deskpro256/Hansab_parking_counter/Parking Project/Installations/ConfiguratorTests/Schematic/Slave_pcb_IRL1.jpg

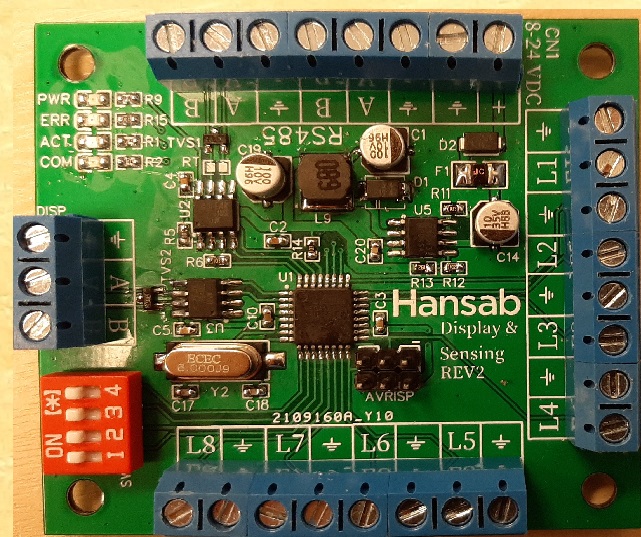
Parking Project/Installations/ConfiguratorTests/Schematic/Slave_pcb_IRL1.jpg
