deskpro256/Hansab_parking_counter/Parking Project/Installations/Installer/readme.txt

Open Setup.msi and install the software.
Upon launching the software either enter username & password
and let the dialog box add your licence
or press the change licence button to add your licence and then log in
