deskpro256/Hansab_parking_counter/Documentation/Hansab_device_specification.pdf

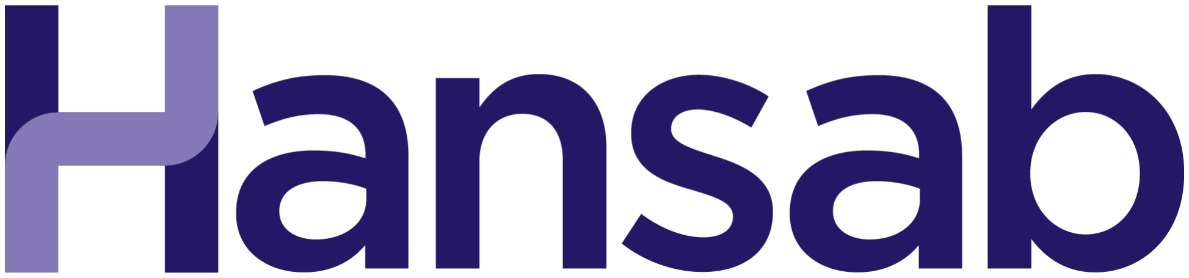
[picture p3: figure]

AUTOSTAVVIETAS BR ¯ | ¯IVO VIETU

# SKAIT¯ITAJS ¯

## Saturs

1. RISINAJUMA APRAKSTS | 2 ¯
2. UZSTAD¯ ¯ISANAS INSTRUKCIJA | 2 ˇ
3. PROGRAMMATURA ¯ | 2
4. ’INTERFEISA’ IER¯ICE | 11
5. ’SLAVE’ IER¯ICE | 18
6. RS485 DATU PROTOKOLS | 23
7. PIELIKUMS | | 25
8. IZMAIN¸ U ZURN ˇ | ALS ¯ | 25

## 1. RISINAJUMA APRAKSTS ¯

1.1. —==[]==—

Nulla malesuada porttitor diam. Donec felis erat, congue non, volutpat at, tincidunt tristique, libero. Vivamus viverra fermentum felis. Donec nonummy pellentesque ante. Phasellus adipiscing semper elit. Proin fermentum massa ac quam. Sed diam turpis, molestie vitae, placerat a, molestie nec, leo. Maecenas lacinia. Nam ipsum ligula, eleifend at, accumsan nec, suscipit a, ipsum. Morbi blandit ligula feugiat magna. Nunc eleifend consequat lorem. Sed lacinia nulla vitae enim. Pellentesque tincidunt purus vel magna. Integer non enim. Praesent euismod nunc eu purus. Donec bibendum quam in tellus. Nullam cursus pulvinar lectus. Donec et mi. Nam vulputate metus eu enim. Vestibulum pellentesque felis eu massa.

## 2. UZSTAD¯ ¯ISANAS INSTRUKCIJA ˇ

2.1. —==[]==—

Nam dui ligula, fringilla a, euismod sodales, sollicitudin vel, wisi. Morbi auctor lorem non justo. Nam lacus libero, pretium at, lobortis vitae, ultricies et, tellus. Donec aliquet, tortor sed accumsan bibendum, erat ligula aliquet magna, vitae ornare odio metus a mi. Morbi ac orci et nisl hendrerit mollis. Suspendisse ut massa. Cras nec ante. Pellentesque a nulla. Cum sociis natoque penatibus et magnis dis parturient montes, nascetur ridiculus mus. Aliquam tincidunt urna. Nulla ullamcorper vestibulum turpis. Pellentesque cursus luctus mauris.

Sist¯emas sl¯egumu piem¯era diagramma:

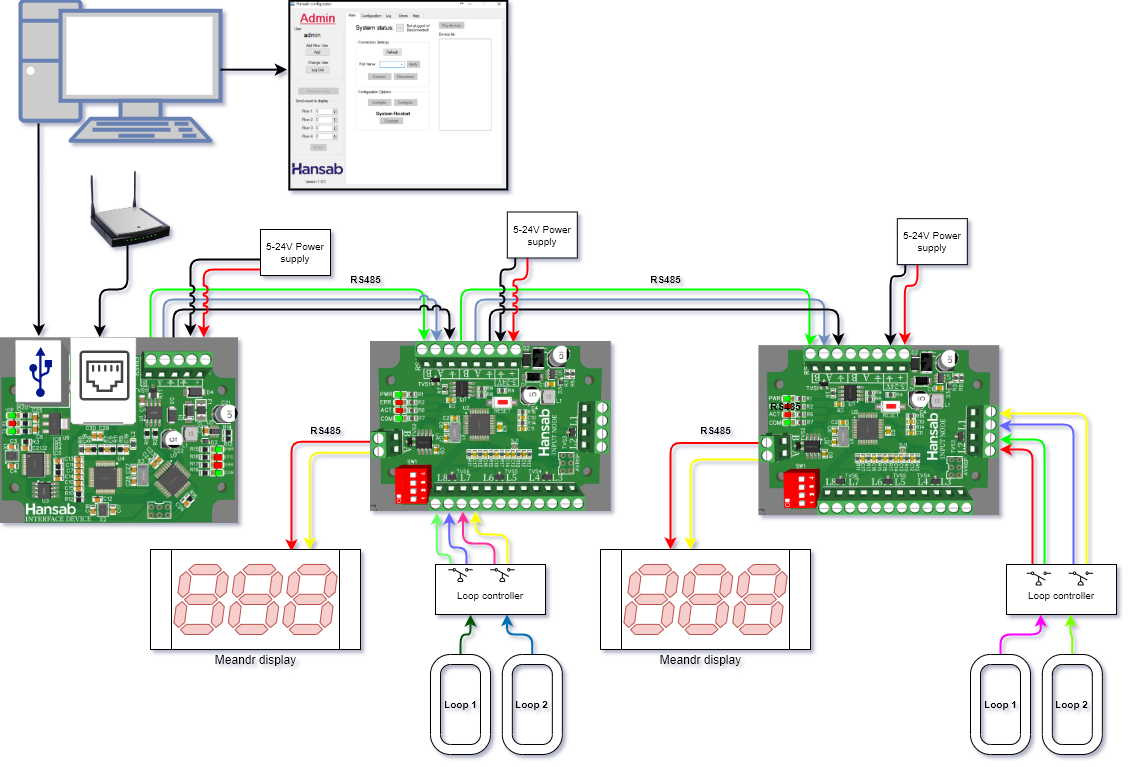
[picture p4: figure]

## 3. PROGRAMMATURA ¯

3.1. —==[]==—

### 3.2. Programmat¯uras apraksts

Programma nepieciešama, lai iestat¯ıtu s¯akotn¯ejo konfigur¯aciju, kur¯a nosaka cik ’slave’ ier¯ıces ir sist¯em¯a, to iestat¯ıjumi, k¯a ar¯ı citi sist¯emas iestat¯ıjumi.
’Interfeisa’ ier¯ıce j¯apiesl¯edz datoram izmantojot USB Type-B vadu, j¯aatver programma. Piekl¸uves log¯a j¯aievada sava lietot¯aja v¯ards un parole. P¯ec vajadz¯ıbas, var izveidot jaunu lietot¯aju, gan admin, gan guest lietot¯aju, kuram b¯us maz¯aka piekl¸uve konfigur¯acijai, bet sist¯emu var¯es p¯arstart¯et un izmain¯ıt pašreiz¯ejo skaitu, ja nepieciešams. Admin lietot¯ajam ir dota pilna kontrole p¯ar sist¯emu.
Lai iestat¯ıtu t¯ıkla iestat¯ıjumus, tas tiek dar¯ıts šaj¯a prgramm¯a.
—-=[+v¯el teksts?]=—-
Lorem ipsum dolor sit amet, consectetuer adipiscing elit. Ut purus elit, vestibulum ut, placerat ac, adipiscing vitae, felis. Curabitur dictum gravida mauris. Nam arcu libero, nonummy eget, consectetuer id, vulputate a, magna. Donec vehicula augue eu neque. Pellentesque habitant morbi tristique senectus et netus et malesuada fames ac turpis egestas. Mauris ut leo. Cras viverra metus rhoncus sem. Nulla et lectus vestibulum urna fringilla ultrices. Phasellus eu tellus sit amet tortor gravida placerat. Integer sapien est, iaculis in, pretium quis, viverra ac, nunc. Praesent eget sem vel leo ultrices bibendum. Aenean faucibus. Morbi dolor nulla, malesuada eu, pulvinar at, mollis ac, nulla. Curabitur auctor semper nulla. Donec varius orci eget risus. Duis nibh mi, congue eu, accumsan eleifend, sagittis quis, diam. Duis eget orci sit amet orci dignissim rutrum.

### 3.3. Programmat¯uras pam¯ac¯ıba

Piekl¸uves logs:

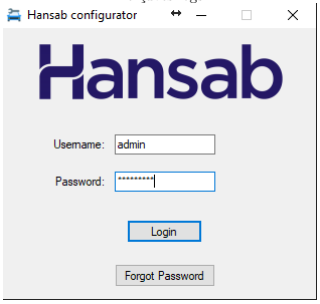
[picture p5: figure]

Piekl¸uves log¯a ievadiet savu lietot¯aja v¯ardu un paroli. Ja parole ir aizmirsusies, nospiediet ’Forgot password’ pogu.
Noklus¯et¯a lietot¯aja dati:
Username: admin
Password: Hansab123
Username: guest
Password: Guest123

Aizmirsu paroli logs:

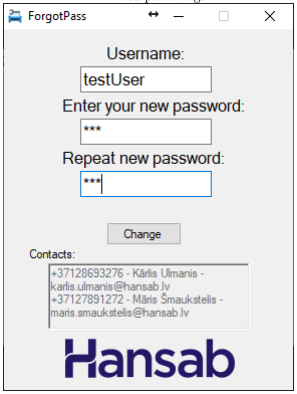
[picture p6: figure]

P¯ec pogas ’Forgot password’ nospiešanas atveras šis logs. Ievadiet savu lietot¯aja v¯ardu un jauno paroli, k¯a ar¯ı atk¯artojiet jauno paroli. Nospiediet pogu ’Change’ un parole tiks nomain¯ıta. P¯ec tam varat m¯e ‘gin¯at piekl¸¯ut atk¯artoti.

Lietot¯aja galvenais logs:

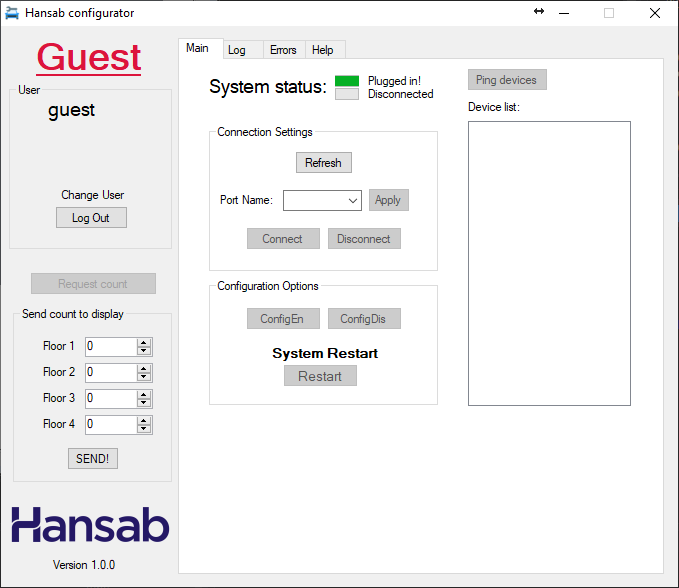
[picture p7: figure]

Ja lietot¯aja tips ir ’Guest’, tad šim lietot¯ajam ir liegta piekl¸uve uz sist¯emai svar¯ıgiem iestat¯ıjumiem. Piem¯eram, nevar izmain¯ıt sist¯emas konfigur¯aciju un nevar izveidot jaunu lietot¯aju.
P¯ec nepieciešam¯ıbas var izmain¯ıt pašreiz¯ejo skaitu k¯adai no ’slave’ ier¯ıc¯em, ja t¯am konstat¯eta kl¸¯uda skait¯a. Gan ’Guest’, gan ’Admin’ lietot¯ajiem, piesl¯edzot ’Interfeisa’ ier¯ıci pie datora, sist¯emas statusa gaismiņa nomain¯ısies no pel¯ekas uz zal¸u, k¯a ar¯ı teksts nomain¯ısies uz ’Online!/Connected!’

Admin galvenais logs:

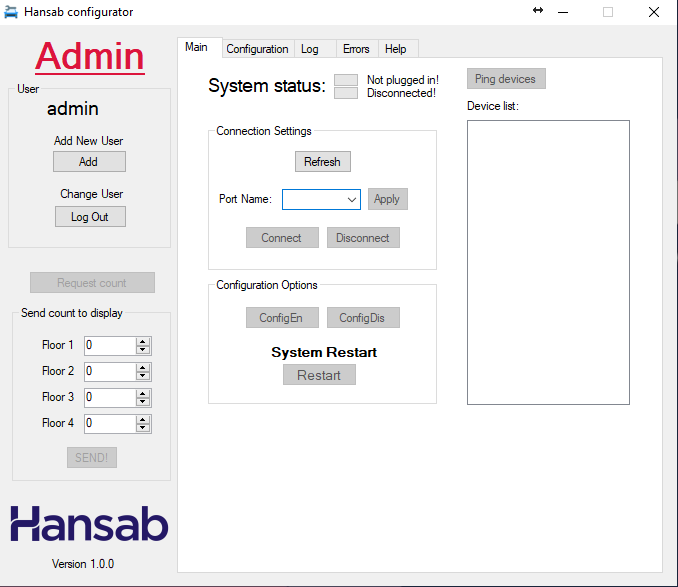
[picture p8: figure]

Ja lietot¯aja tips ir ’Admin’, tad šim lietot¯ajam ir piekl¸uve uz visiem sist¯emas iestat¯ıjumiem.
Var pievienot jaunus lietot¯ajus, gan ’Admin’, gan ’Guest’ tipa, izmain¯ıt vai uzst¯ad¯ıt jaunu sist¯emas konfigur¯aciju.
Gan ’Guest’, gan ’Admin’ lietot¯ajiem, piesl¯edzot ’Interfeisa’ ier¯ıci pie datora, sist¯emas statusa gaismiņa nomain¯ısies no pel¯ekas uz zal¸u, k¯a ar¯ı teksts nomain¯ısies uz ’Online!/Connected!’

Admin konfigur¯acijas logs:

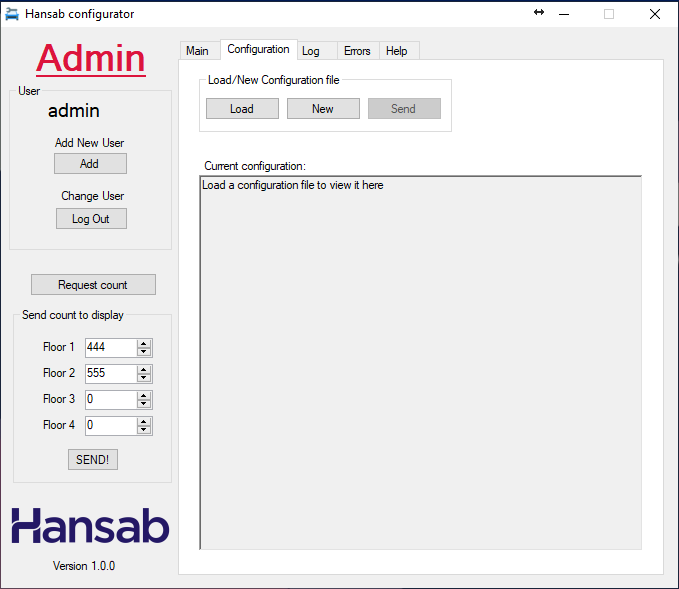
[picture p9: figure]

Uzspiežot uz ’Configuration’ cilnes, par¯ad¯as 2 pogas un teksta logs:

’Load’ - Iel¯ad¯e jau esošu konfigur¯acijas failu no saglab¯ata faila;
’New’ - Atver jaunu logu, kur¯a iesp¯ejams izveidot jaunu konfigur¯acijas failu;
’Current configuration’ teksta logs - kur¯a, p¯ec esošas konigur¯acijas faila iel¯ad¯ešanas, par¯ad¯as š¯ı faila saturs. P¯ec tam šo konfigur¯aciju var iel¯ad¯et uz pašreiz¯ej¯as sist¯emas.

Admin konfigur¯acijas logs:

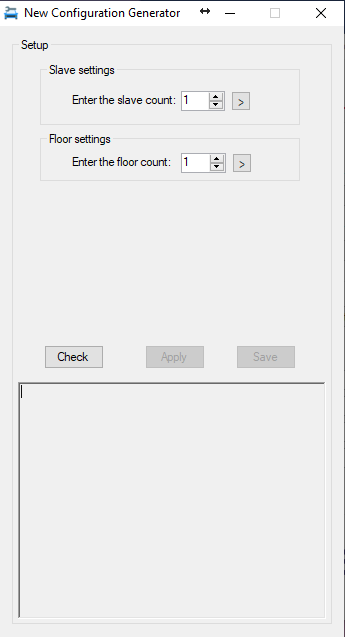
[picture p10: figure]

Ja tiek veikta jauna konfigur¯acijas uzst¯ade, atveras jauns logs, kur¯a iesp¯ejams iestat¯ıt šlave¯ıer¯ıču skaitu sist¯em¯a, k¯a ar¯ı st¯avu skaitu un to individu¯alo br¯ıvo vietu skaitu.

Admin konfigur¯acijas logs:

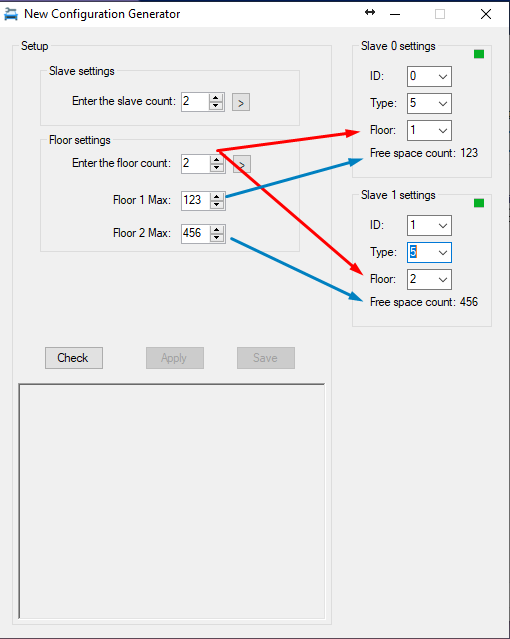
[picture p11: figure]

Sadal¸¯a ’Floor n’ (n - st¯ava skaits) par¯ad¯ısies ’Free space count’, kur¯a j¯aievada st¯avlaukuma br¯ıvo vietu skaits un ’Slave count’, kur¯a j¯aievada piesl¯egto ’slave’ ier¯ıču skaits. Nospiežam ’Next’
Par¯ad¯ısies jauna sadal¸a ’Slave settings’, kur¯a iesp¯ejams iestat¯ıt ’slave’ ier¯ıču datus:
Ier¯ıces ID (0-15)
Ier¯ıces tipu (1-3)
Ier¯ıces st¯avu/zonu (1-4)

Ier¯ıces tipu apraksts:

Tips 1: | [↓] [↑] - Atsevišk¸a iebrauktuve un atsevišk¸a izbrauktuve
Tips 2: | [Eko] - Ekonomiskais(ar vienu cilpu) Tikai iebrauktuve / izbrauktuve
Tips 3: | [↓ ↑] - Kop¯eja iebrauktuve/izbrauktuve

Admin konfigur¯acijas logs:

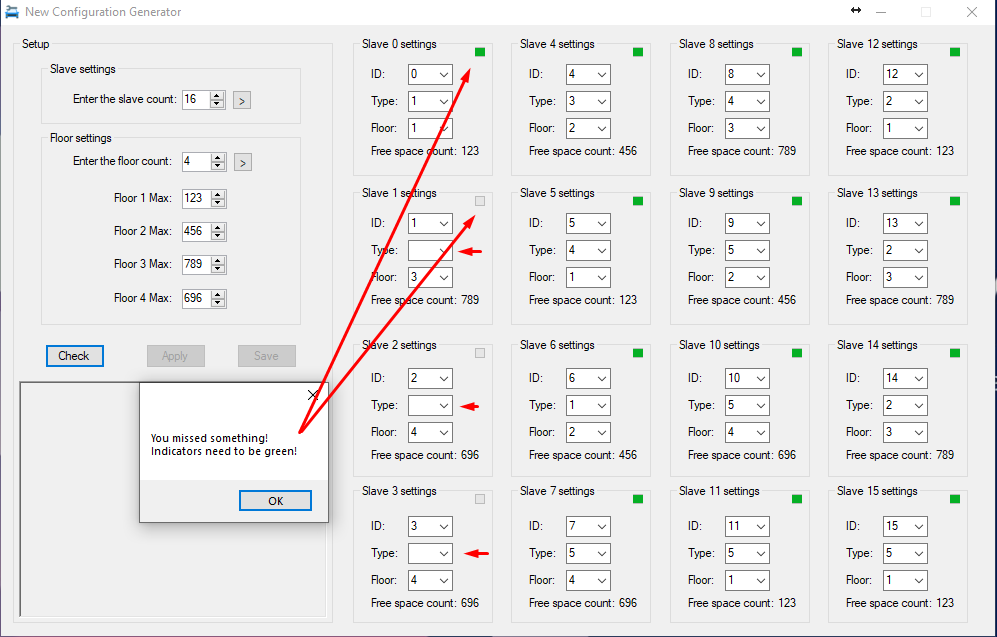
[picture p12: figure]

Kad visi iestat¯ıjumi uzst¯ad¯ıti, nospiediet ’Check’, kas p¯arbaud¯ıs vai visi nepieciešamie lauciņi ir aizpild¯ıti.
Ja nav aizpild¯ıti visi lauciņi, p¯ec ’Check’ pogas nospiešanas par¯ad¯ısies att¯el¯a redzamais logs, kas br¯ıdina, ka j¯us neesat aizpild¯ıjis visus lauciņus. Pel¯ekie indikatori p¯arv¯eršas par zal¸iem, ja ’slave settings’ lauciņš ir aizpild¯ıts. Tom¯er, ja viss aizpild¯ıts pareizi, atsl¯egsies pogas ’Apply’ un ’Save’, kas l¸aus j¯usu izveidoto konfigur¯aciju saglab¯at k¯a failu, k¯a ar¯ı p¯ec tam nos¯ut¯ıt uz uzst¯ad¯ıto sist¯emu.

Jauna lietot¯aja pievienošana:

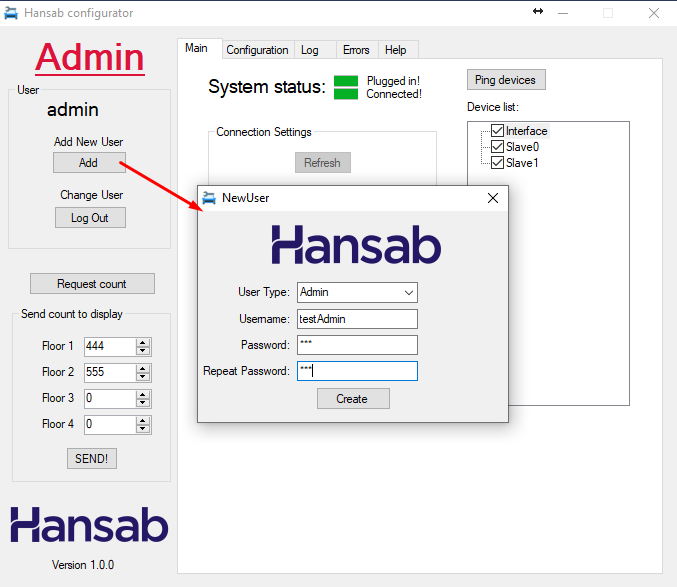
[picture p13: figure]

Ja vajadz¯ıgs izveidot jaunu lietot¯aju, to var izdar¯ıt nospiežot uz pogas ’Add’ galven¯a pragrammas loga kreisaj¯a mal¯a, kas atv¯ers šo logu.
Izv¯elieties lietot¯aja tipu (Guest/Admin).
Ievadiet lietot¯aja v¯ardu, paroli un v¯elreiz atk¯artojiet paroli.
Nospiežot ’Create’, tiks izveidots jaunais lietot¯ajs un par¯ad¯ısies logs, inform¯ejot par to.

Kl¸¯udu saraksta logs:

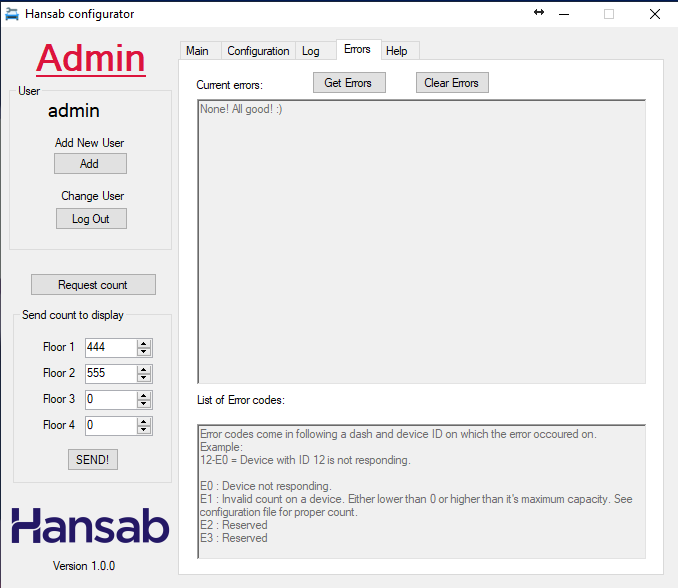
[picture p14: figure]

Saj¯a ciln¯e atrodama aktu¯al¯a inform¯acija par uzst¯ad¯ıt¯as sist¯emas kl¸¯udu sarakstu. ˇ
Ja k¯adu iemeslu d¯el¸ sist¯em¯a ir radusies kl¸¯uda, piesl¯edzot ’Interfeisa’ ier¯ıci pie datora, šeit tiks izveidots saraksts ar kl¸¯udainaj¯am ier¯ıc¯em ar to aprakstiem.

Piem¯ers:
Ja kl¸¯udu nav, tekstlog¯a ’Current errors’ b¯us rakst¯ıts: ’None! All good! :)
Zem¯akaj¯a tekstlog¯a ’List of error codes’ ir apraksts, k¯a las¯ıt kl¸¯udas sarakst¯a doto inform¯aciju.

Kl¸¯udu kodu piem¯ers:

12-E1
Saprast: Ier¯ıce ar ID 12 neatsaucas.

Kl¸¯udu kodu saraksts:

E0 : Nav kl¸¯udas;
E1 : Ier¯ıce neatsaucas;
E2 : Nepareizs br¯ıvo vietu skaits ier¯ıc¯e. Skat¯ıt konfigur¯acijas failu p¯ec atbilstoš¯a pareiz¯a skaita; E3 : Rezerv¯ets.

Pal¯ıdz¯ıbas logs:

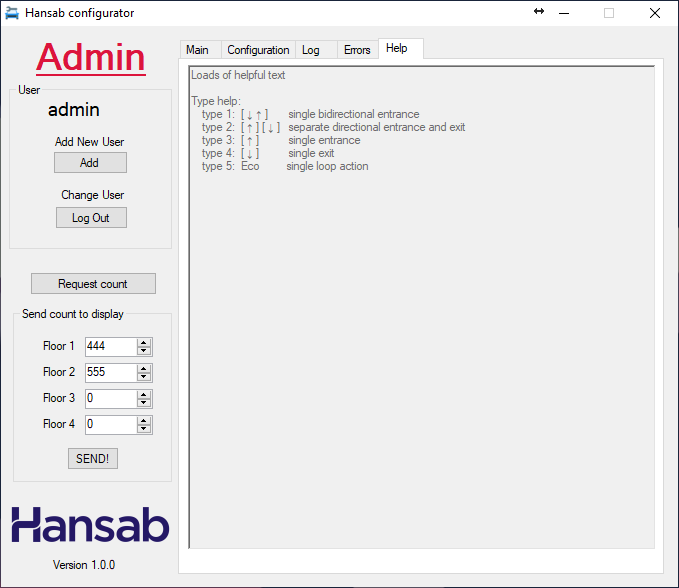
[picture p15: figure]

Saj¯a ciln¯e atrodama inform¯acija, kas noder¯etu uzst¯ades br¯ıd¯ı, k¯a ar¯ı p¯ec t¯as. ˇ Varb¯ut ar¯ı kontakti k¯adi?—??
Links uz Hansab lapu ar šo risin¯ajumu? https://www.hansab.lv/404

## 4. ’INTERFEISA’ IER¯ICE

4.1. ’Interfeisa’ ier¯ıces apraksts

’Interfeisa’ ier¯ıce nodrošina galveno saziņu starp sist¯em¯a sasl¯egtaj¯am ier¯ıc¯em, k¯a ar¯ı savienojumam ar datoru un konfigur¯acijas programmat¯uru.
’Interfeisa’ ier¯ıce ar datoru sazinas izmantojot USB, bet ar vis¯am p¯ar¯ej¯am ’slave’ ier¯ıc¯em sazinas izmantojot RS485 ar pašizveidotu datu protokolu, kas aprakst¯ıts t¯al¯ak dokument¯a, sadal¸¯a ’RS485 DATU PROTO-KOLS’.

Papildus ier¯ıc¯e darbojas WebServeris, kur¯a iesp¯ejams piesl¯egties att¯alin¯ati un var redz¯et sist¯emas statusu un izmain¯ıt sist¯emas pašreiz¯ejo skaitu.

Ier¯ıcei var piekl¸¯ut ar jebkuru t¯ıkla p¯arl¯uk apal¯ıdz¯ıbu, ierakstot saites lodziņ¯a iek¯artas IP adresi.

Interfeisa ier¯ıces WebServera ielogošan¯as logs:

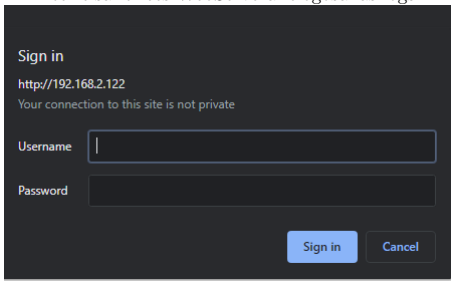
[picture p16: figure]

Seit ievadam savu lietot¯ajv¯ardu un paroli lai turpin¯atu uz galveno lapu. ˇ

Interfeisa ier¯ıces WebServera pašreiz¯ejo datu lapa:

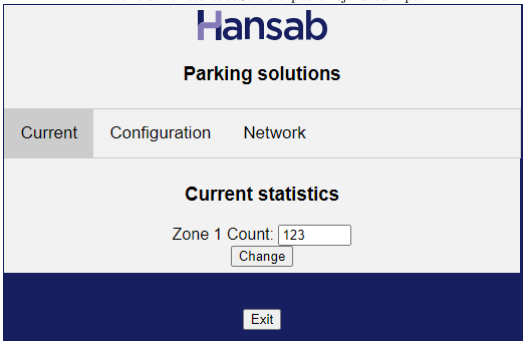
[picture p17: figure]

Seit varam redz¯et datus par pašreiz¯ejo skaitu sist¯em¯a un tos izmain¯ıt nos¯utot tos uz ier¯ıci. ˇ

Interfeisa ier¯ıces WebServera sist¯emas iestat¯ıjumi:

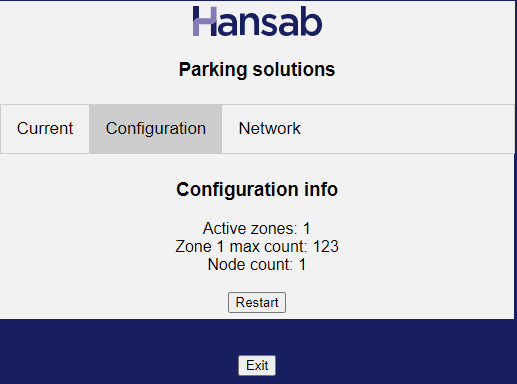
[picture p18: figure]

Seit apskat¯ami dati par to, k¯a sist¯ema uzst¯ad¯ıta. Aprakst¯ıti maksim¯alie skaitl¸i un tas, cik zonas/st¯avi sist¯em¯a ˇ tiek lietoti, k¯a ar¯ı ’slave’ iek¯artu skaits. P¯ec nepieciešam¯ıbas, var iek¯artu ar¯ı p¯arstart¯et.

Interfeisa ier¯ıces WebServera t¯ıkla iestat¯ıjumi:

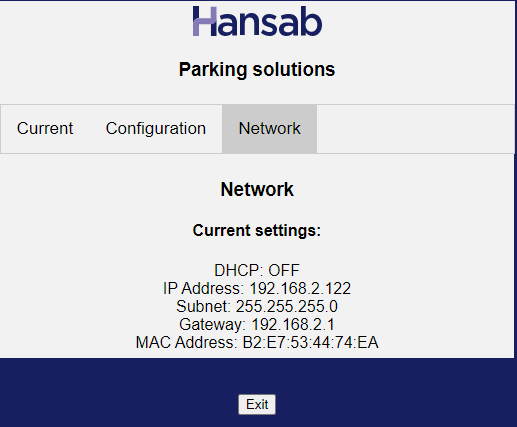
[picture p19: figure]

Seit var redz¯et ier¯ıces pašreiz¯ejos t¯ıkla iestat¯ıjumus. ˇ

Ja k¯adus no šiem istat¯ıjumiem nepieciešams izmain¯ıt, tas j¯adara izmantojot programmu, kas paredz¯eta konfigur¯acijai.
Lai tehnik¸iem b¯utu viegl¯ak noteikt, vai raduš¯as probl¯emas, uz PCB ir izvietotas 4 indikatoru LED:

USB(zal¸a) - sp¯ıd, ja ier¯ıce ir piesl¯egta pie USB;
EXT(zal¸a) - sp¯ıd, ja ier¯ıce ir piesl¯egta pie ¯ar¯ej¯as barošanas;
COM(zal¸a) - iedegas katru reizi, kad saņem vai izs¯uta ziņojumu;
ERR(sarkana) - sp¯ıd, ja radusies k¯ada kl¸¯uda skait¯a vai k¯ads cits kl¸¯udas veids; CFG(sarkana) - sp¯ıd, ja ier¯ıce tiek konfigur¯eta, nospiežot pogu programm¯a; RX(sarkana) - iedegas katru reizi, kad saņem ziņojumu no programmas caur USB; TX(zal¸a) - iedegas katru reizi, kad izs¯uta ziņojumu no programmas caur USB;

### 4.2. Iek¯artas noklus¯ejuma iestat¯ıjumi:

*Sist¯emas iestat¯ıjumi:
Slave count: 1
Zone 1 Count: 123
Zone 2 Count: 0
Zone 3 Count: 0
Zone 4 Count: 0
*T¯ıkla iestat¯ıjumi:
DHCP: OFF
IP: 192.168.2.122
GW: 255.255.255.0
SN: 192.168.2.1
*Web piekl¸uve:
username: admin
password: Hansab123

### 4.3. Tehniskie dati

Galvenais mikrokontrolieris | 8-bit Atmel ATmega328P-AU
Takts frekvence | 8 MHz
Atmiņa | 32KB FLASH, 2KB SRAM, 1KB EEPROM
Darba spriegums | 3.3V (Pašregul¯ejošs uz ier¯ıces)
Str¯avas pat¯eriņš | 100 mA MAX
Ieejas spriegums | 5V - 24V DC
Temperat¯uras notur¯ıba | -40◦ C l¯ıdz +85◦ C
Savienojam¯ıba | USB, Ethernet, RS485
Fiziskie izm¯eri | 7.3cm x 5.3cm (garums x platums)

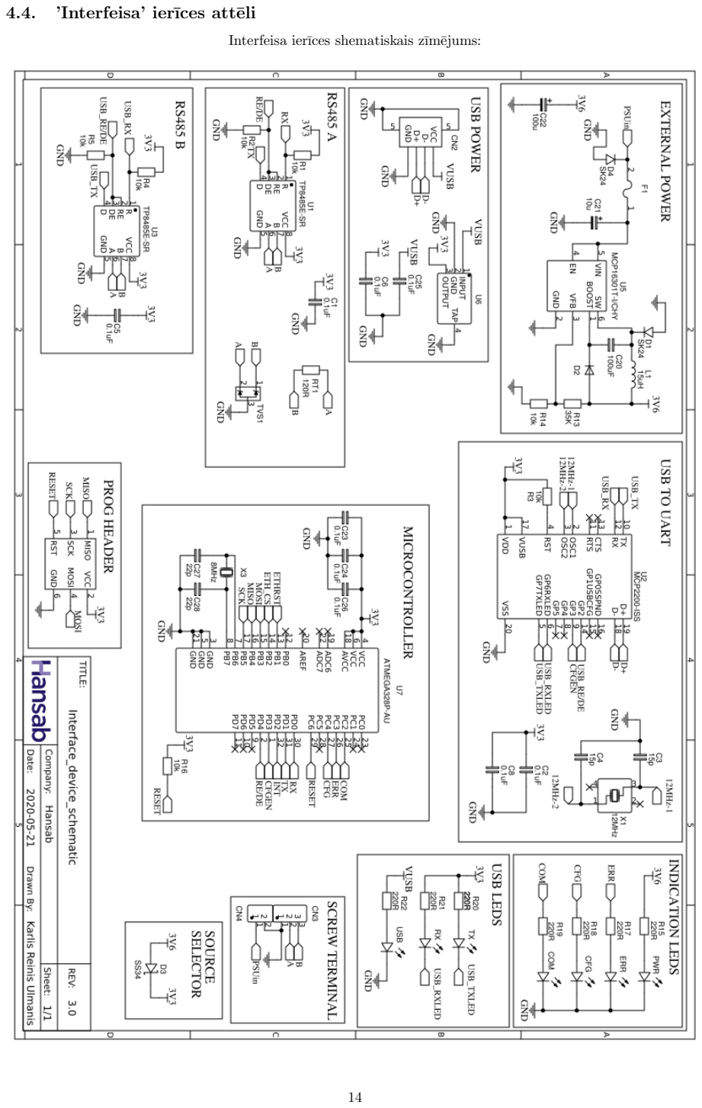
[picture p20: page 14]

4.4. ’Interfeisa’ ier¯ıces att¯eli

Interfeisa ier¯ıces shematiskais z¯ım¯ejums:

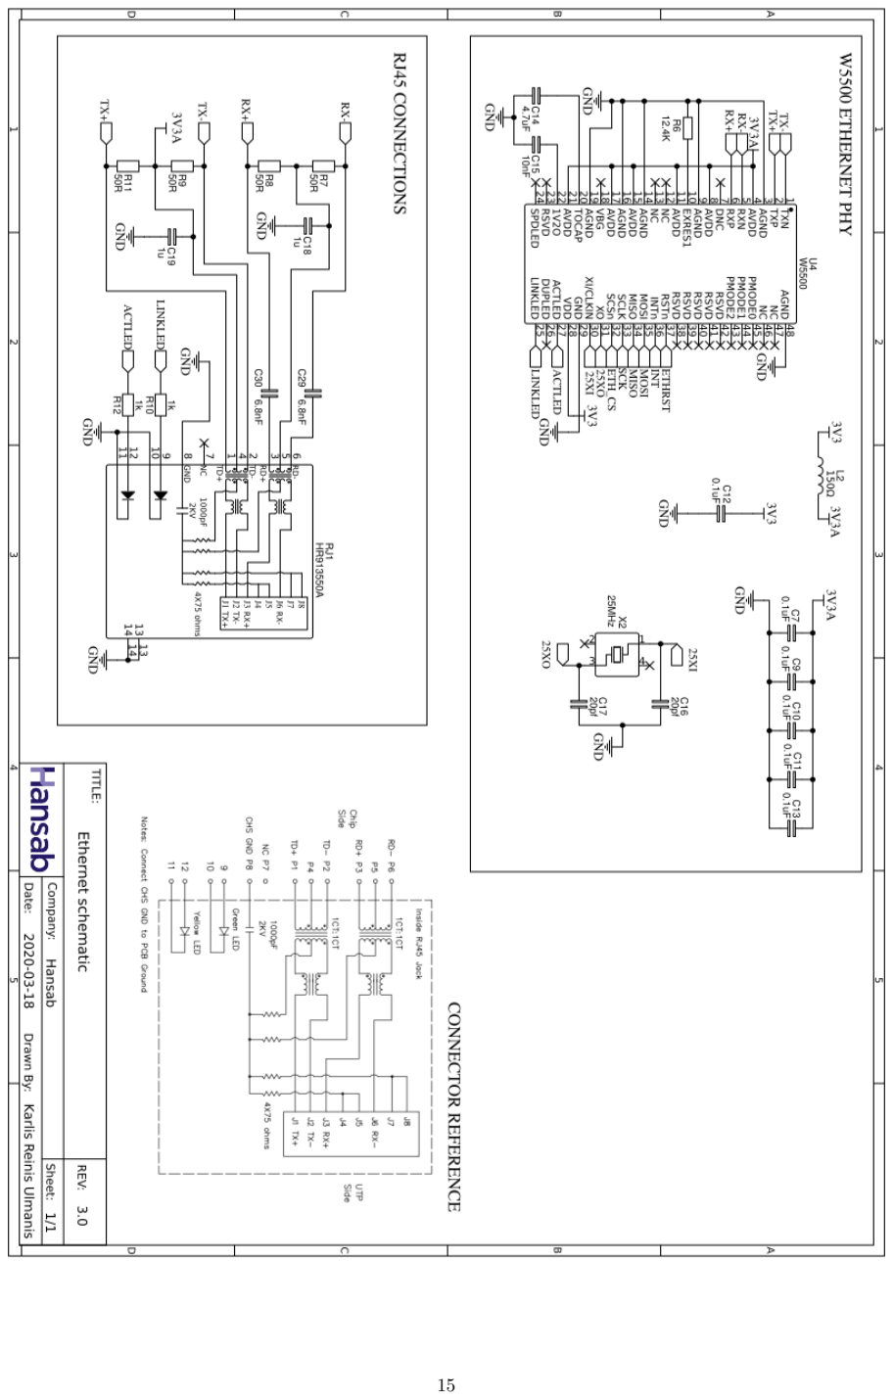
[picture p21: page 15]

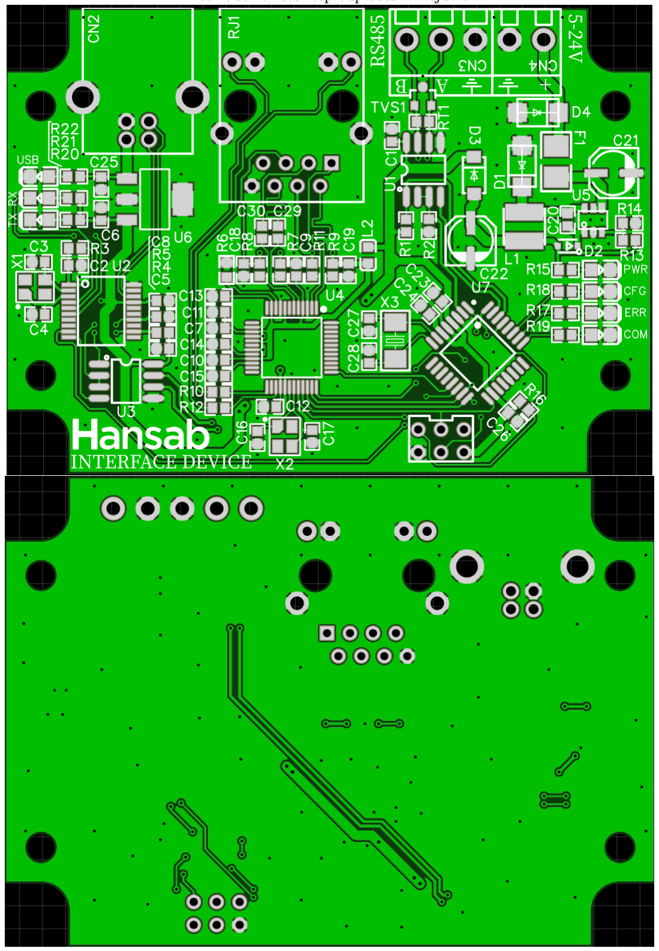
[picture p22: figure]

Interfeisa ier¯ıces iespiedplates z¯ım¯ejums:

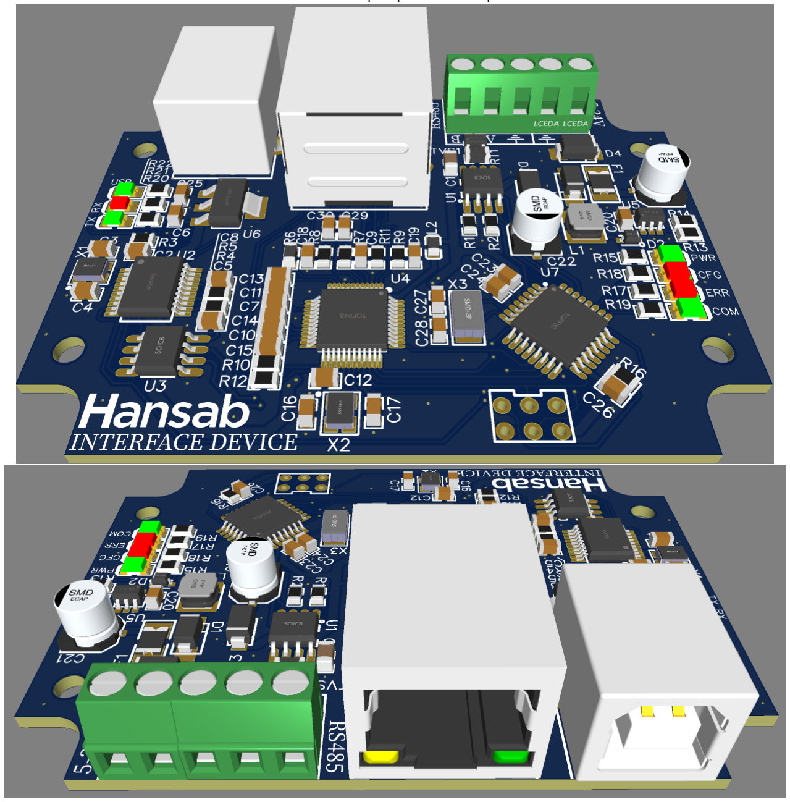
[picture p23: figure]

Interfeisa ier¯ıces iespiedplate ar komponent¯em:

## 5. ’SLAVE’ IER¯ICE

5.1. ’Slave’ ier¯ıces apraksts

!!!!!!!!!!! [Labot info] !!!!!!!!!!!! Katrai “slave” ier¯ıcei ir 8 piesl¯egumi sensoru izej¯am, kas
Lx&Ly (ACTIVE LOW) p¯arus, k¯a ar¯ı 7-segmentu displejus ar atsevišk¸u RS485 izvadu izmantojot “Meandr” datu protokolu ar p¯arraides ¯atrumu: 9600 bit/sec.

Ja cel¸š tiek izmantots gan k¯a iebrauktuve, gan k¯a izbrauktuve, kurai nepieciešams noteikt brauksanas virzienu A::B(iebraucot) vai B::A(izbraucot), tad VEK-M2E-2-A nepieciešams piesl¯egt pie L1&L2 vai L3&L4.

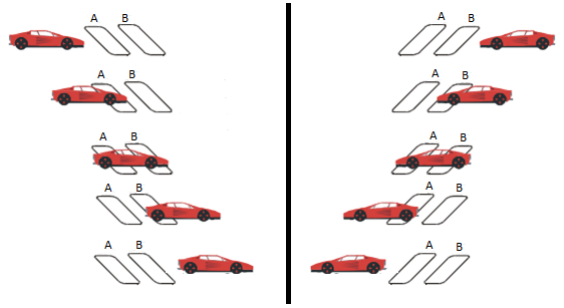
[picture p24: figure]

L1, L3 - A cilpa
L2, L4 - B cilpa

Slave ier¯ıču tipi:
Tips 1: Atsevišk¸a izbrauktuve un iebrauktuve L1 - L4 = OUT (L1&&L2)-(L3&&L4)
L5 - L8 = IN (L5&&L6)-(L7&&L8)
Tips 2: Eco Darb¯ıba ar vienu sensore izeju L1 - L4 = OUT (L1)(L2)(L3)(L4)
L5 - L8 = IN (L5)(L6)(L7)(L8)
Tips 3: Iebrauktuve ir t¯a pati, kas izbrauktuve L1 - L4 = IN/OUT (L1::L2)(L3::L4)
L5 - L8 = IN/OUT (L5::L6)(L7::L8)

Lai tehnik¸iem b¯utu viegl¯ak noteikt vai raduš¯as problemas, uz PCB ir izvietotas 4 indikatoru LED:

PWR(zal¸a) - sp¯ıd, ja ier¯ıce ir piesl¯egta pie ¯ar¯ej¯as barošanas;
COM(zal¸a) - iedegas katru reizi, kad saņem vai izs¯uta ziņojumu;
ACT(sarkana) - iedegas, kad p¯ari k¯adam no sensoru ieej¯am šk¸¯erso auto; ERR(sarkana) - sp¯ıd, ja radusies k¯ada kl¸¯uda skait¯a vai k¯ads cits kl¸¯udas veids.

### 5.2. Iek¯artas noklus¯ejuma iestat¯ıjumi:

*Sist¯emas iestat¯ıjumi:
Type: 1
Zone: 1
Count: 123
5.3. ’Slave’ ier¯ıču ID

Katrai ’Slave’ ier¯ıcei nepieciešams iestat¯ıt t¯as adresi (ID), kas l¸aus sist¯em¯a tai komunic¯et ar p¯ar¯ej¯am ier¯ıc¯em un tikt nokonfigur¯et¯am. S¯akotn¯eji vis¯am ier¯ıc¯em p¯ec ražošanas ir vien¯adi ID.

ID iestata izmantojot uz ier¯ıces redzam¯a ’DIP’ sl¯edža, kam ir 4 poz¯ıcijas, kas darbojas k¯a 4-bitu adreses. Ja nepiecišams nomain¯ıt iek¯artas ID kam¯er iek¯arta darbojas, vispirms izmaina ID uz vajadz¯ıgo un tad nospiež ’Reset’ pogu uz ier¯ıces.

DIP adreses sl¯edzis:

ID TABULA:

ID | DIP1 | DIP2 | DIP3 | DIP4
0 | ON | ON | ON | ON
1 | ON | ON | ON | -
2 | ON | ON | - | ON
3 | ON | ON | - | -
4 | ON | - | ON | ON
5 | ON | - | ON | -
6 | ON | - | - | ON
7 | ON | - | - | -
8 | - | ON | ON | ON
9 | - | ON | ON | -
10 | - | ON | - | ON
11 | - | ON | - | -
12 | - | - | ON | ON
13 | - | - | ON | -
14 | - | - | - | ON
15 | - | - | - | -

### 5.4. Tehniskie dati

Galvenais mikrokontrolieris | 8-bit Atmel ATmega328P-AU
Takts frekvence | 8 MHz
Atmiņa | 32KB FLASH, 2KB SRAM, 1KB EEPROM
Darba spriegums | 3.3V (Pašregul¯ejošs uz ier¯ıces)
Str¯avas pat¯eriņš | 100 mA MAX
Ieejas spriegums | 5V - 24V DC
Temperat¯uras notur¯ıba | -40◦ C l¯ıdz +85◦ C
Savienojam¯ıba | RS485
Fiziskie izm¯eri | 7.3cm x 5.3cm (garums x platums)

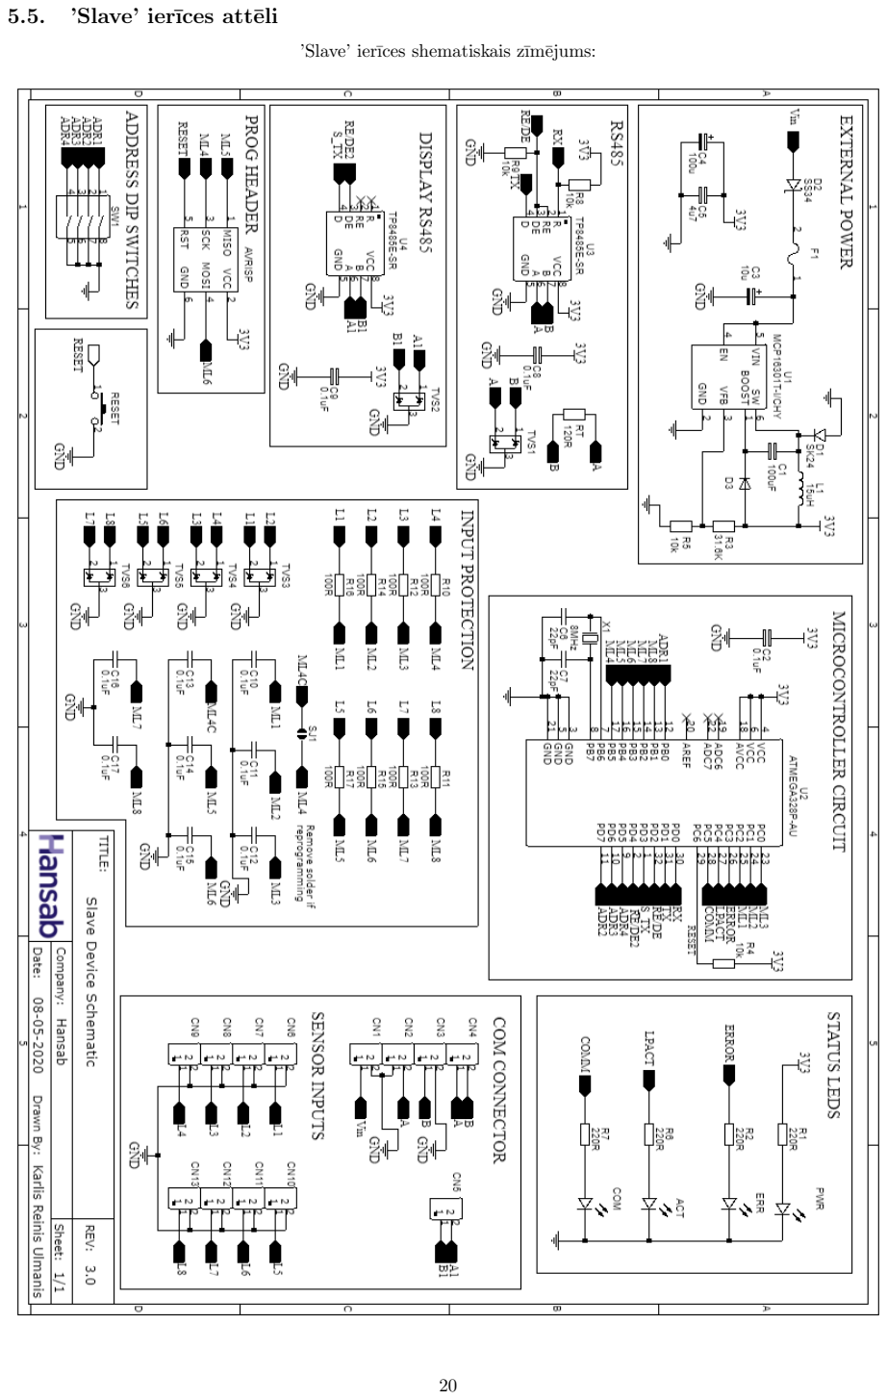
[picture p25: page 20]

5.5. ’Slave’ ier¯ıces att¯eli

’Slave’ ier¯ıces shematiskais z¯ım¯ejums:

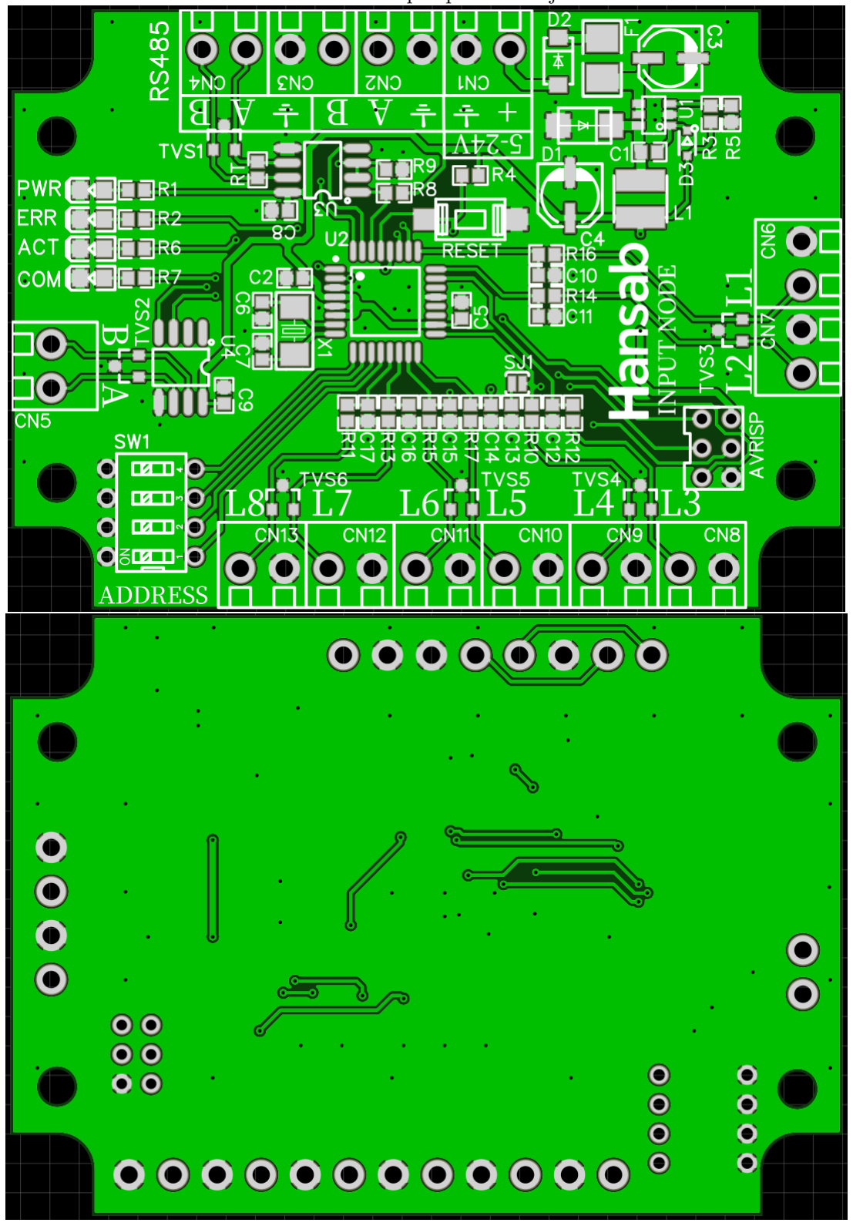
[picture p26: figure]

’Slave’ ier¯ıces iespiedplates z¯ım¯ejums:

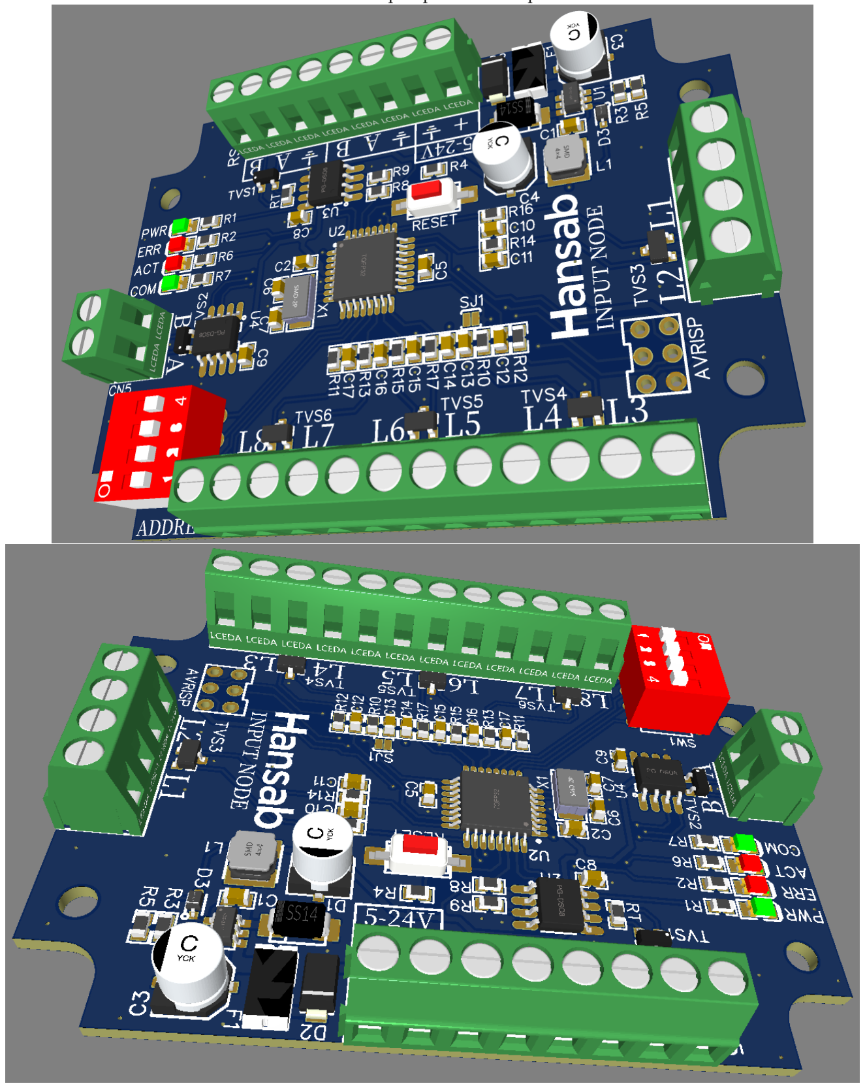
[picture p27: figure]

’Slave’ ier¯ıces iespiedplate ar komponent¯em:

## 6. RS485 DATU PROTOKOLS

Visas ier¯ıces sav¯a starp¯a sazin¯as izmantojot RS485. RS485 datu p¯arraides ¯atrums: 9600 bit/sec
RS485 datu ziņas form¯ats:
STX | RxID | TxID | MSGType | CMD | DATA1 | DATA2 | DATA3 | ETX
1byte | 1byte | 1byte | 1byte | 1byte | 1byte | 1byte | 1byte | 1byte
0x5B | 0x01 | 0x00 | 0x05 | 0x05 | 0x00 | 0x64 | 0x24 | 0x5D

Ziņas sast¯ava paskaidrojums:

STX[hex] | Ziņas starta bits | 0x5B ’[’
RxID[hex] | Saņ¯em¯eja ID | [0x00 - 0x0F, 0x1C, 0x1D]
TxID[hex] | S¯ut¯ıt¯aja ID | [0x00 - 0x0F, 0x1C, 0x1D]
MSGType[hex] | Ziņas tips | [0x05, 0x06, 0x15]
CMD[hex] | Komanda | [0x02 - 0x0A]
DATA1[hex] | Simti | [0x00 - 0xFF]
DATA2[hex] | Desmiti | [0x00 - 0xFF]
DATA3[hex] | Vieni | [0x00 - 0xFF]
ETX[hex] | Ziņas beigu bits | 0x5D ’]’

Ziņas tipu veidi:

[0x05]: ENQ - Vaic¯ajuma ziņa. Interfeisa ier¯ıce aptauj¯a ’slave’ ier¯ıces un sagaida atbildes ziņu saturot ACK/NAK. [0x06]: ACK - Ja ’slave’ ier¯ıces atbilde ir ’J¯a’, tad atbildes tips is ACK
[0x15]: NAK - Ja ’slave’ ier¯ıces atbilde ir ’N¯e’, tad atbildes tips is NAK

Piem¯ers 1 (’Slave’ ier¯ıcei nav kl¸¯uda):
Interfeisa ier¯ıce jaut¯a vai ’slave’ ier¯ıcei ir kl¸¯uda. Ziņas tips satur ENQ. ’Slave’ ier¯ıce atbild ar NAK, jo tai nav kl¸¯uda.

Piem¯ers 2 (’Slave’ ier¯ıcei ir nepareizs skaits):
Interfeisa ier¯ıce jaut¯a vai ’slave’ ier¯ıcei ir kl¸¯uda. Ziņas tips satur ENQ. ’Slave’ ier¯ıce atbild ar ACK, jo tai ir radusies kl¸¯uda skait¯a.

Komandu veidi:

[0x02]: Get Changes
[0x03]: Send Display Count [0x04]: Clear Errors
[0x05]: First Time Setup
[0x06]: Ping
[0x07]: Send Display Count To USB [0x08]: Send Error Report
[0x09]: Restart
[0x0A]: Network Settings
[0x0B]: Send Network Settings
[0x0C]: Send MAC Settings

Slave ier¯ıces RS485 pirmreiz¯ej¯as uzst¯ades datu ziņas form¯ata piem¯ers:

STX | RxID | TxID | CMD | Type | FloorID | Data1 | Data2 | Data3 | ETX
1byte | 1byte | 1byte | 1byte | 1byte | 1byte | 1byte | 1byte | 1byte | 1byte
0x5B | 0x01 | 0x1C | 0x05 | 0x02 | 0x01 | 0x31 | 0x32 | 0x33 | 0x5D

Interfeica ier¯ıces RS485 pirmreiz¯ej¯as uzst¯ades datu ziņas form¯ata piem¯ers:

STX | RxID | TxID | CMD | SLCNT | F1CNT1 | F1CNT2 | F1CNT3 | F2CNT1
1byte | 1byte | 1byte | 1byte | 1byte | 1byte | 1byte | 1byte | 1byte
0x5B | 0x01 | 0x1C | 0x05 | 0x02 | 0x31 | 0x32 | 0x33 | 0x31
F2CNT2 | F2CNT3 | F3CNT1 | F3CNT2 | F3CNT3 | F4CNT1 | F4CNT2 | F4CNT3 | ETX
1byte | 1byte | 1byte | 1byte | 1byte | 1byte | 1byte | 1byte | 1byte
0x32 | 0x33 | 0x31 | 0x32 | 0x33 | 0x31 | 0x32 | 0x33 | 0x5D

Interfeica ier¯ıces t¯ıkla iestat¯ıjumu datu ziņas form¯ata piem¯ers:

STX | RxID | TxID | CMD | DHCP | IP1 | IP2 | IP3 | IP4
1byte | 1byte | 1byte | 1byte | 1byte | 1byte | 1byte | 1byte | 1byte
0x5B | 0x1D | 0x1C | 0x05 | 0x00 | 0xC0 | 0xA8 | 0x00 | 0xB1
SN1 | SN2 | SN3 | SN4 | GW1 | GW2 | GW3 | GW4 | ETX
1byte | 1byte | 1byte | 1byte | 1byte | 1byte | 1byte | 1byte | 1byte
0xFF | 0xFF | 0xFF | 0x00 | 0xC0 | 0xA8 | 0x00 | 0x01 | 0x5D

Interfeica ier¯ıces MAC adreses uzst¯ades datu ziņas form¯ata piem¯ers:

STX | RxID | TxID | CMD | MAC1 | MAC2 | MAC3 | MAC4 | MAC5 | MAC6 | ETX
1byte | 1byte | 1byte | 1byte | 1byte | 1byte | 1byte | 1byte | 1byte | 1byte | 1byte
0x5B | 0x01 | 0x1C | 0x0C | 0xB2 | 0xE7 | 0x53 | 0x44 | 0x74 | 0xEA | 0x5D

## 7. PIELIKUMS

8. | IZMAIN¸ U ZURN ˇ | ALS ¯
1 | Pirmreiz¯ej¯a dokumenta sagatavošana. K¯arlis Reinis Ulmanis. 05/08/2019
2 | Ier¯ıču att¯elu izmaiņas atbilstoši jaunaj¯am iespiedpalt¯em. K¯arlis Reinis Ulmanis. 29/05/2020
3 | -
