deskpro256/Hansab_parking_counter/Parking Project/Installations/ConfiguratorTests/Schematic/Sensor_Layout.pdf

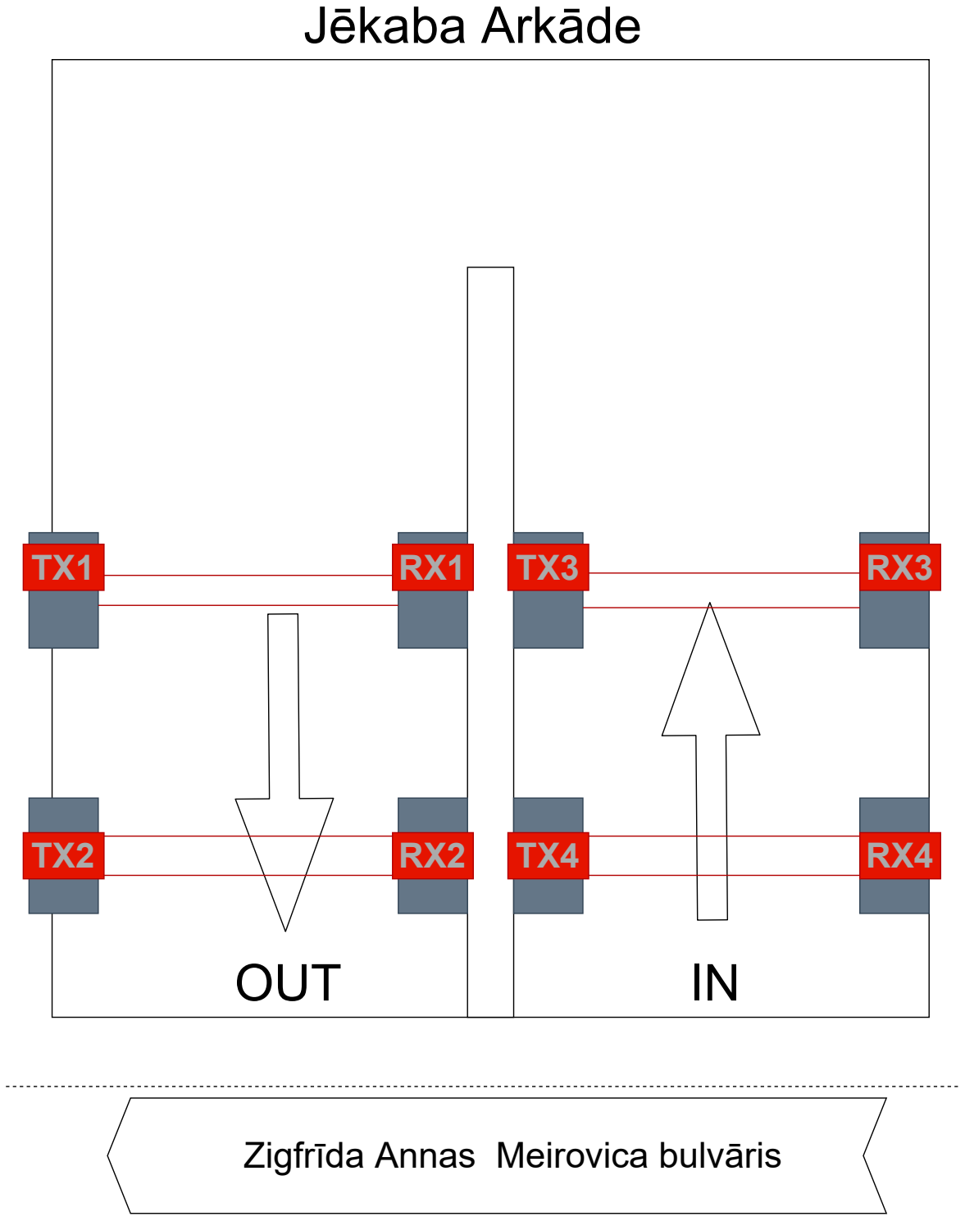
[picture p28: figure]
Jēkaba Arkāde; Zigfrīda Annas Meirovica bulvāris; OUT
