deskpro256/Hansab_parking_counter/Parking Project/Ampron displejs/Weight station_Ampron_visual.pdf

1. Car drives on the weight station
NR | ---
KG | ---
GO | ---
NB

SOOJAK

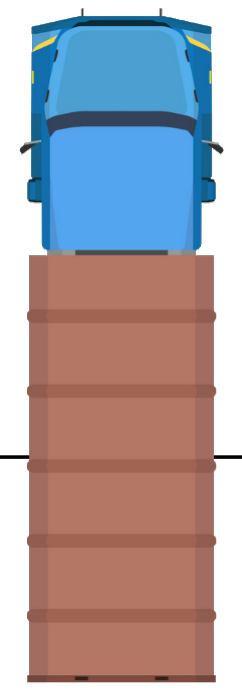
[picture p29: figure]

51 23 67 87 Probleemide korral В случае проблем

2.1 Car number registered - OK.

NR | 123ABC
KG | ---
GO | ---
NB

SOOJAK

51 23 67 87 Probleemide korral В случае проблем

2.2 Car number is not registered

NR | ???
KG | ---
GO | ---
NB | PUHA…

SOOJAK

51 23 67 87 Probleemide korral В случае проблем

NB PUHASTA NUMBER VÕI KASUTA KAARTI

3. Registering weight
NR | 123ABC
KG
KAI | ---
NB

SOOJAK

51 23 67 87 Probleemide korral В случае проблем

4.1 weighting is OK.

NR | 123ABC
KG | 15 431
KAI | 13
NB

SOOJAK

51 23 67 87 Probleemide korral В случае проблем

4.2 Wighting is not OK, leave station

NR | 123ABC
KG | ---
KAI | ---
NB | VABA…

SOOJAK

51 23 67 87 Probleemide korral В случае проблем

NB VABASTA KAAL

5.1 Weight is OK

NR | 123ABC
KG | 15 431
KAI | 13
NB | ↑

SOOJAK

51 23 67 87 Probleemide korral В случае проблем

5.2 Weight OK. Weight tare while going back

NR | 123ABC
KG | 15 431
KAI | 13
NB | TÜHJ…

SOOJAK

51 23 67 87 Probleemide korral В случае проблем

NB TÜHJA TAARA KAALUMINE

6. Car leaves station

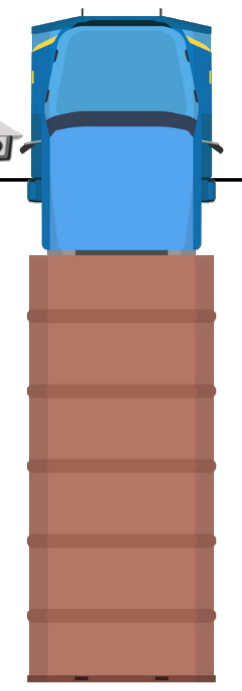
[picture p30: figure]

NR | ---
KG | ---
KAI | ---
NB

SOOJAK

51 23 67 87 Probleemide korral В случае проблем
