deskpro256/Hansab_parking_counter/Documentation/Interface/REV3/Ethernet.png

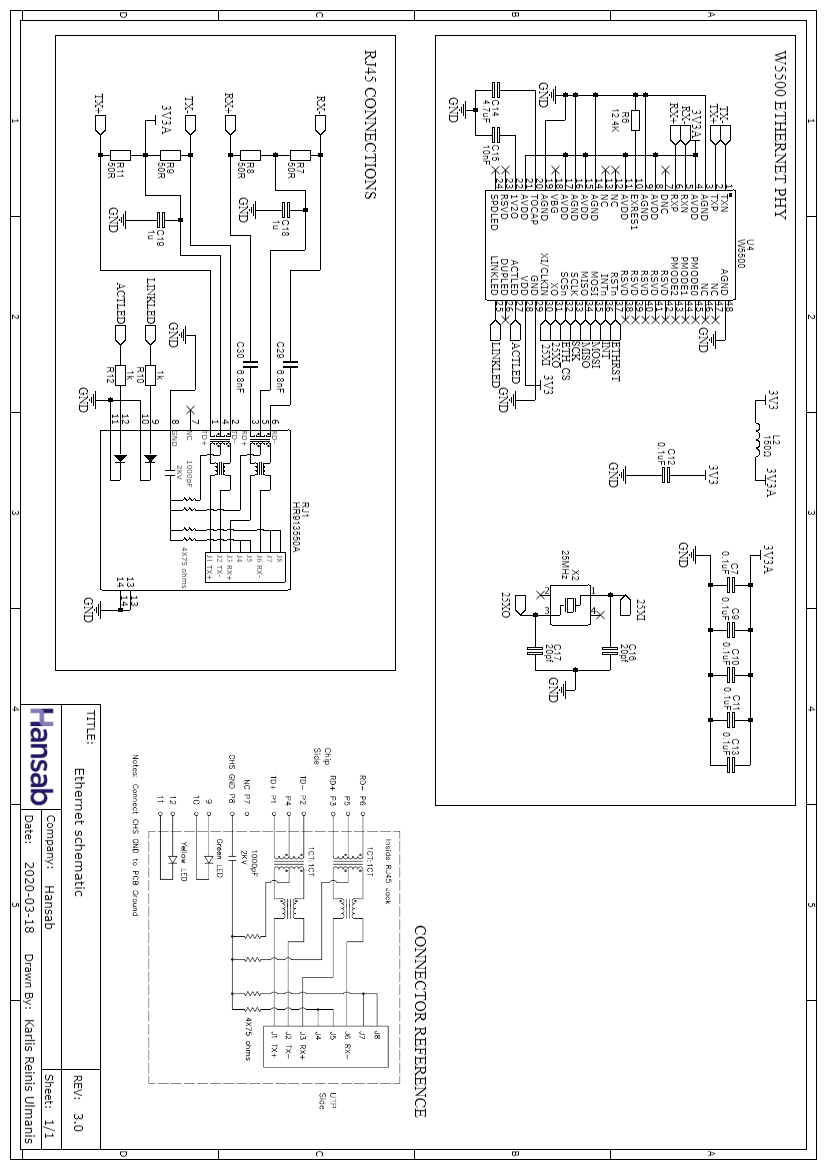
Documentation/Interface/REV3/Ethernet.png
