deskpro256/Hansab_parking_counter/Documentation/Interface/REV3/Interface_3D_2.png

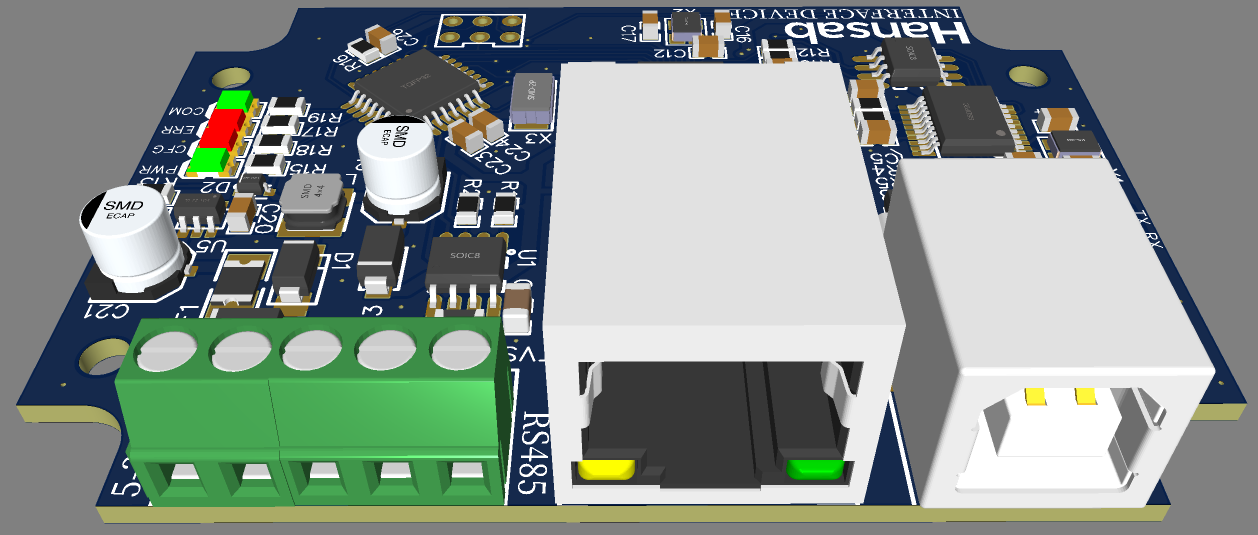
Documentation/Interface/REV3/Interface_3D_2.png
