deskpro256/Hansab_parking_counter/Documentation/Interface/REV3/Interface_Bottom_PCB.png

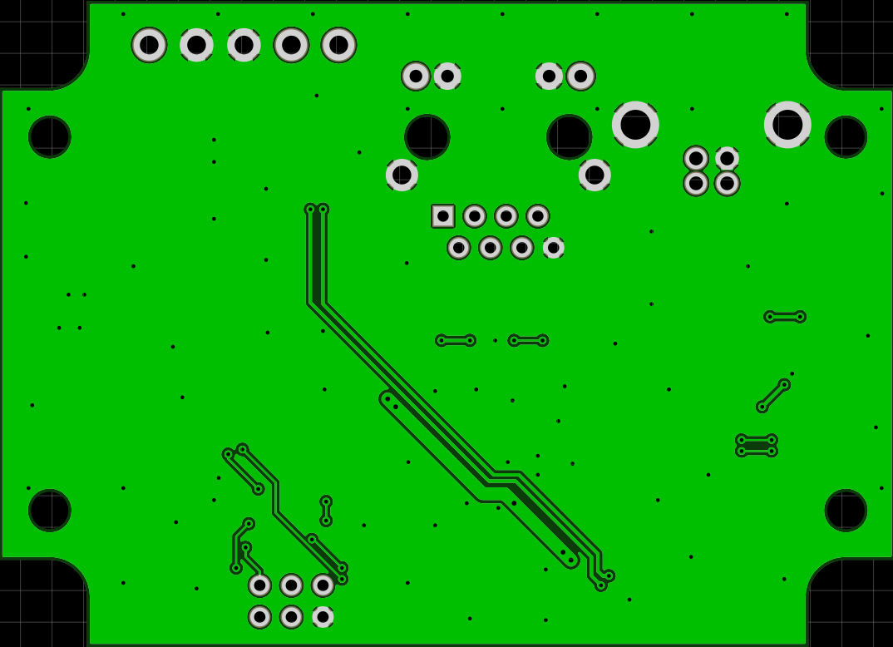
Documentation/Interface/REV3/Interface_Bottom_PCB.png
