deskpro256/Hansab_parking_counter/Documentation/Interface/REV3/Interface_device_schematic.png

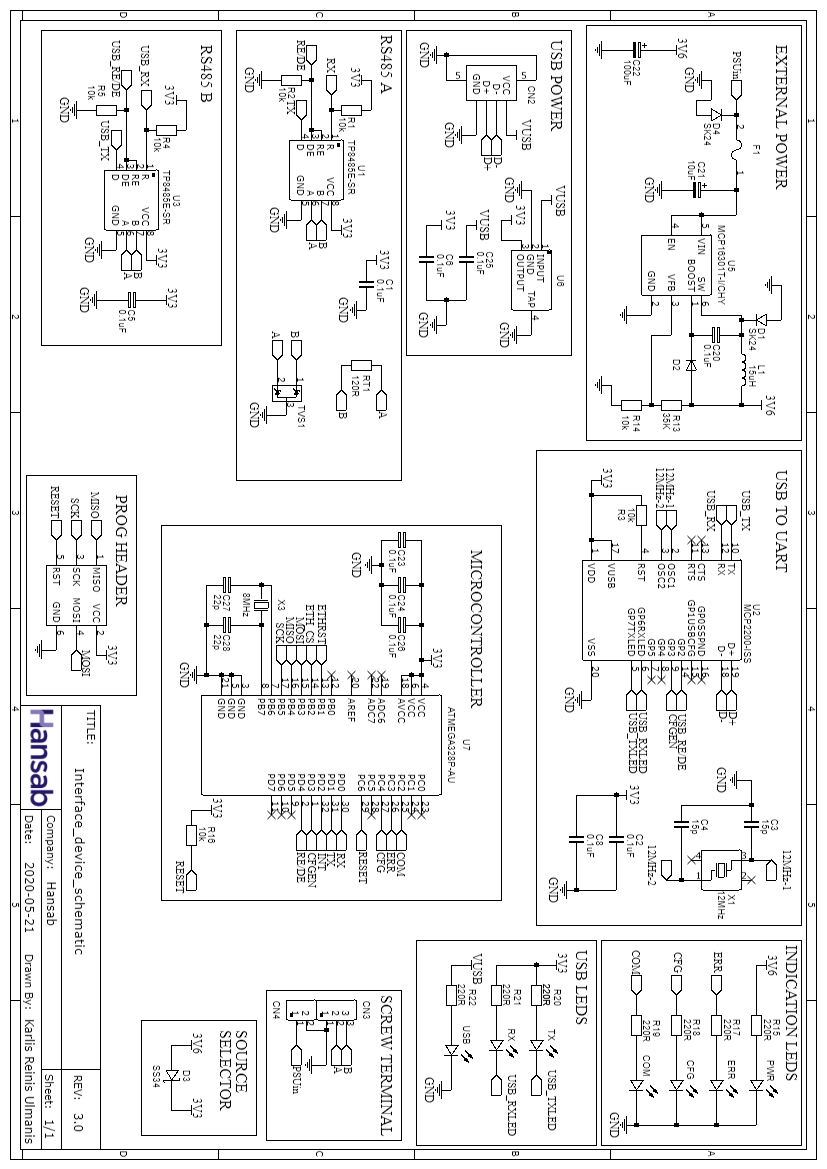
Documentation/Interface/REV3/Interface_device_schematic.png
