deskpro256/Hansab_parking_counter/Documentation/Program/Images/Admin_Configuration_5.png

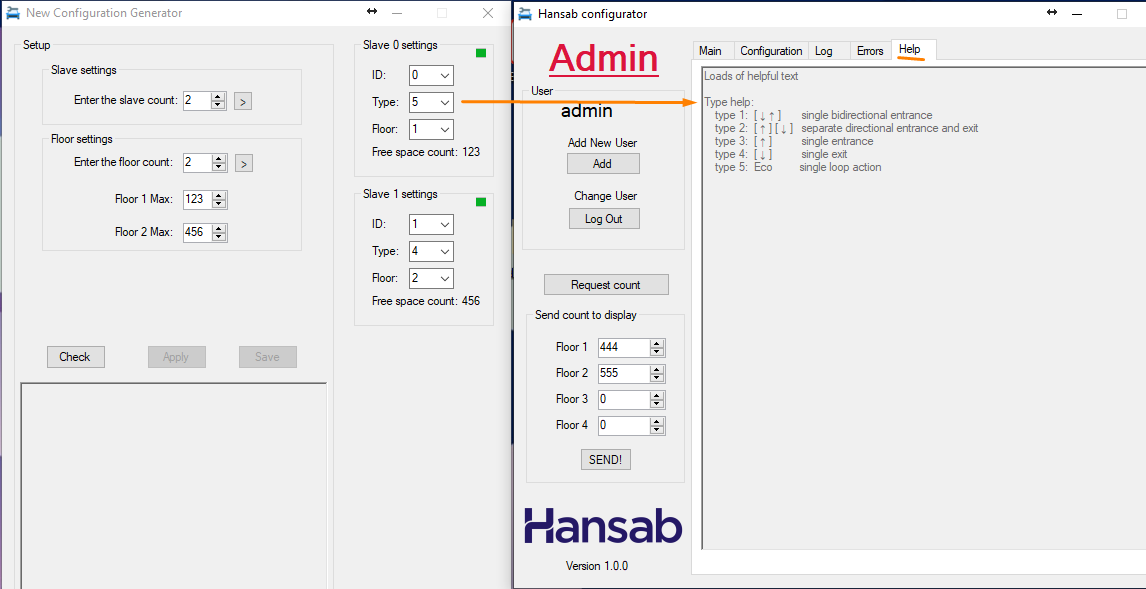
Documentation/Program/Images/Admin_Configuration_5.png
