deskpro256/Hansab_parking_counter/Documentation/Program/Images/Admin_Main_Reset_2.png

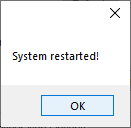
Documentation/Program/Images/Admin_Main_Reset_2.png
