deskpro256/Hansab_parking_counter/Documentation/Slave/REV3/dip.jpeg

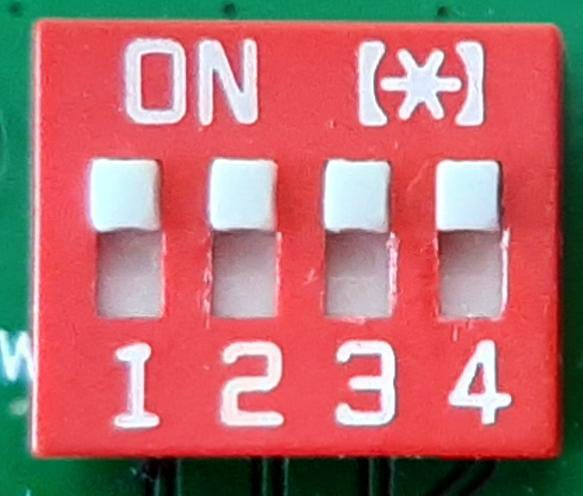
Documentation/Slave/REV3/dip.jpeg
