deskpro256/Hansab_parking_counter/Documentation/Slave/REV3/Schematic_Slave.png

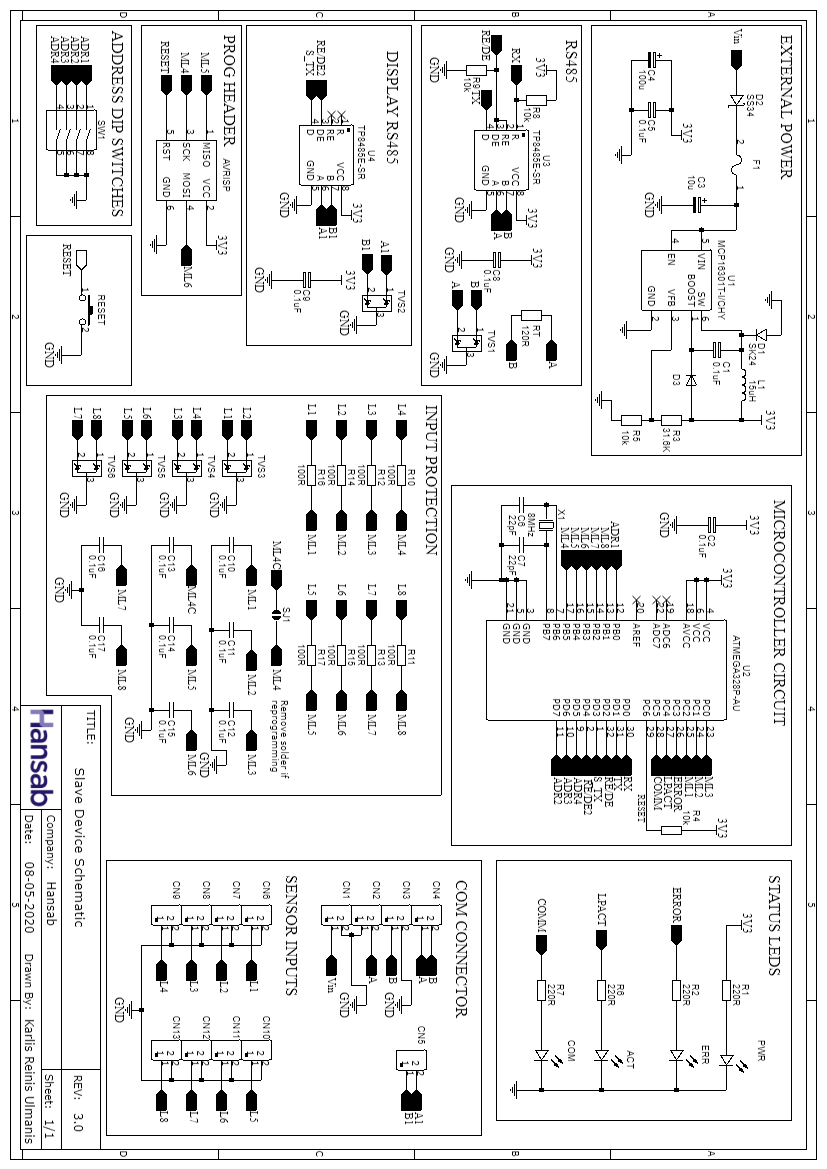
Documentation/Slave/REV3/Schematic_Slave.png
