deskpro256/Hansab_parking_counter/Documentation/Slave/REV3/Slave_3D_2.png

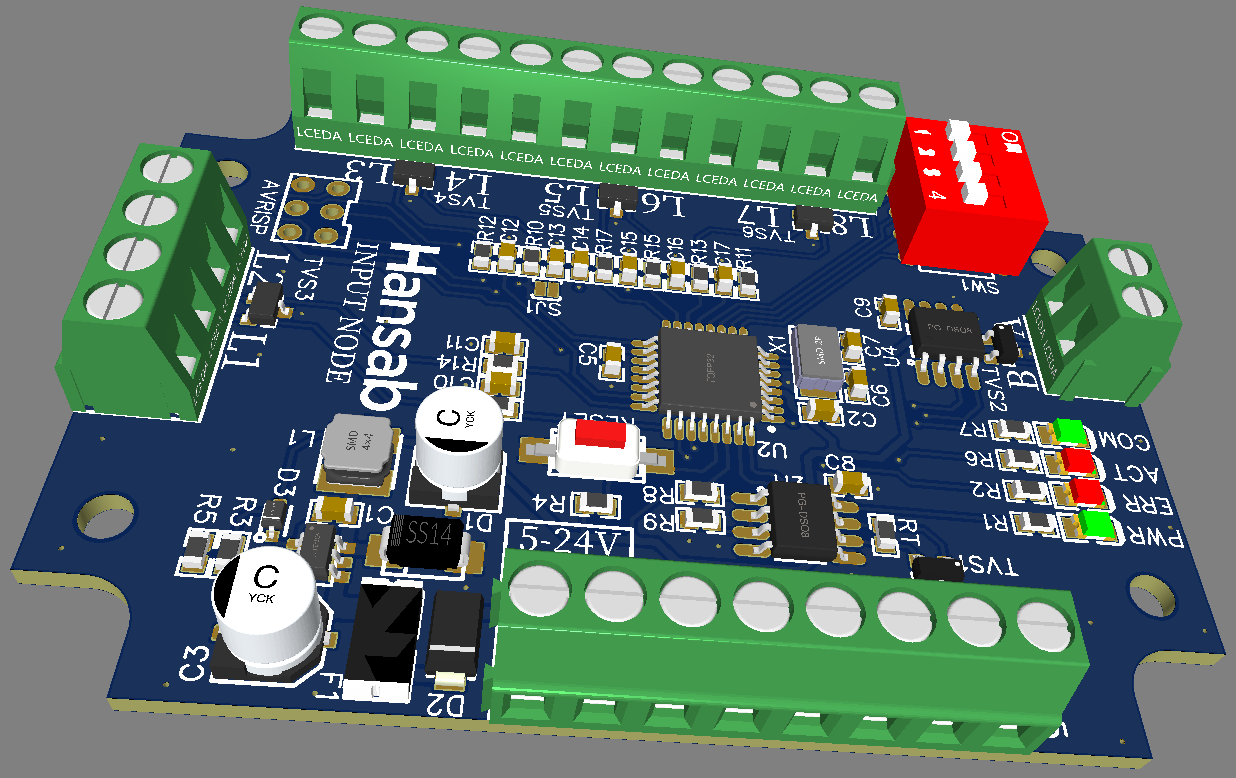
Documentation/Slave/REV3/Slave_3D_2.png
