deskpro256/Hansab_parking_counter/Documentation/Slave/REV3/Slave_Bottom_PCB.png

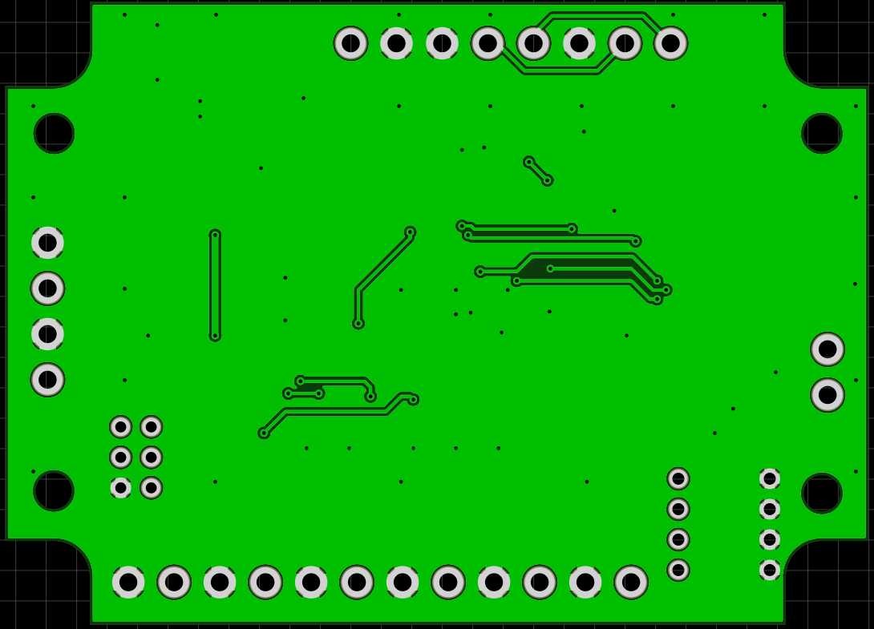
Documentation/Slave/REV3/Slave_Bottom_PCB.png
