deskpro256/Hansab_parking_counter/Documentation/Slave/REV3/Slave_Top_PCB.png

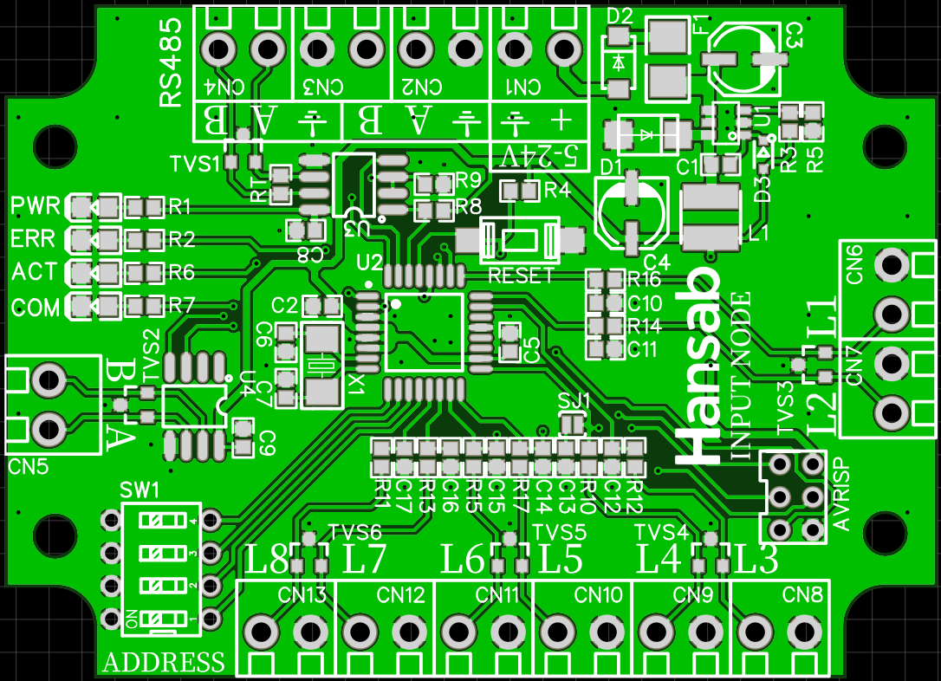
Documentation/Slave/REV3/Slave_Top_PCB.png
