deskpro256/Hansab_parking_counter/Hardware/Invoices/REV2/1115796220_INV_RIX_GTW_001_20191111_114736.tif

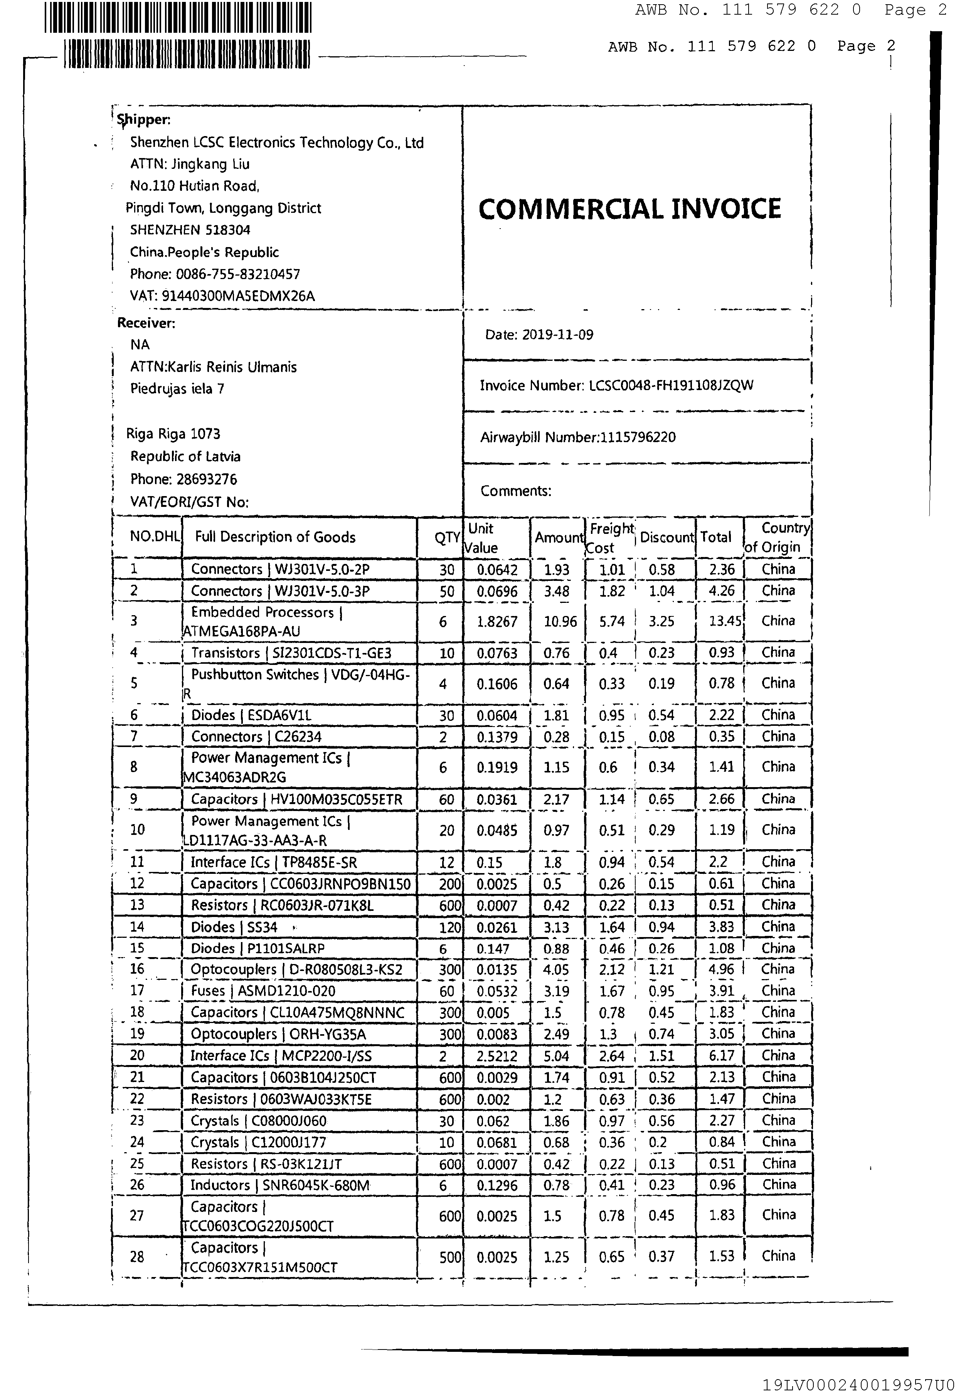
Hardware/Invoices/REV2/1115796220_INV_RIX_GTW_001_20191111_114736.tif
