deskpro256/Hansab_parking_counter/Parking Project/Ampron displejs/DS-320x320 P8 - Tallink Megastar.jpg

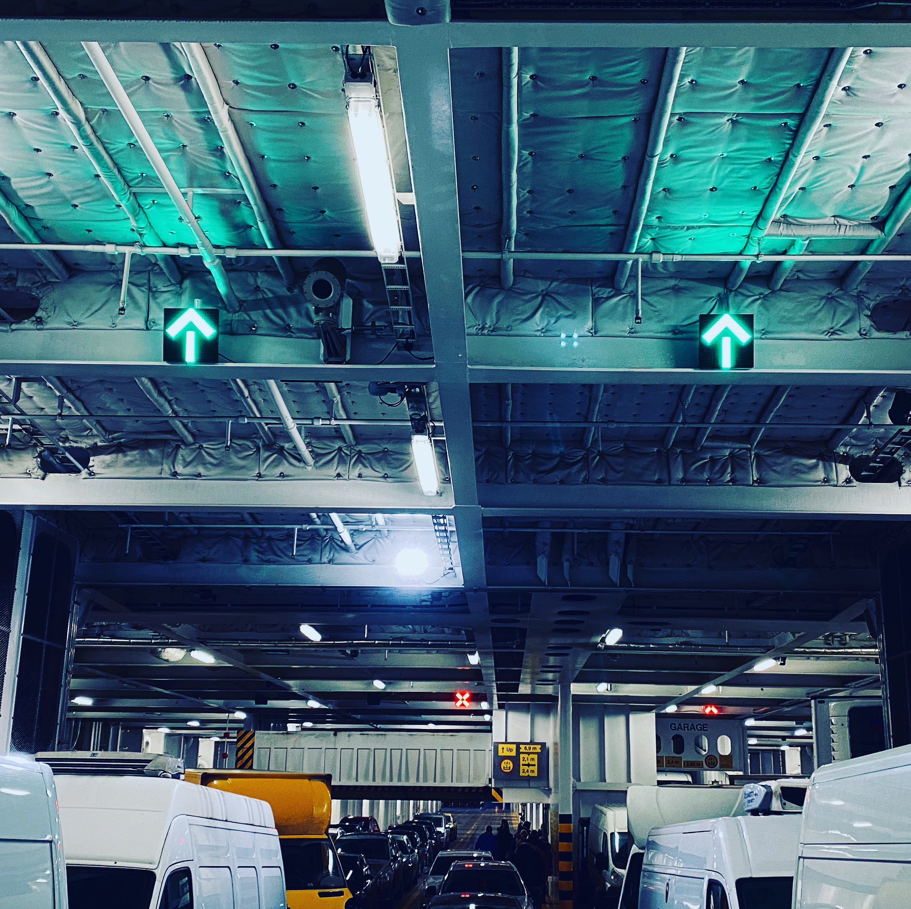
Parking Project/Ampron displejs/DS-320x320 P8 - Tallink Megastar.jpg
