deskpro256/Hansab_parking_counter/Parking Project/Images/Admin_Configuration_Page.png

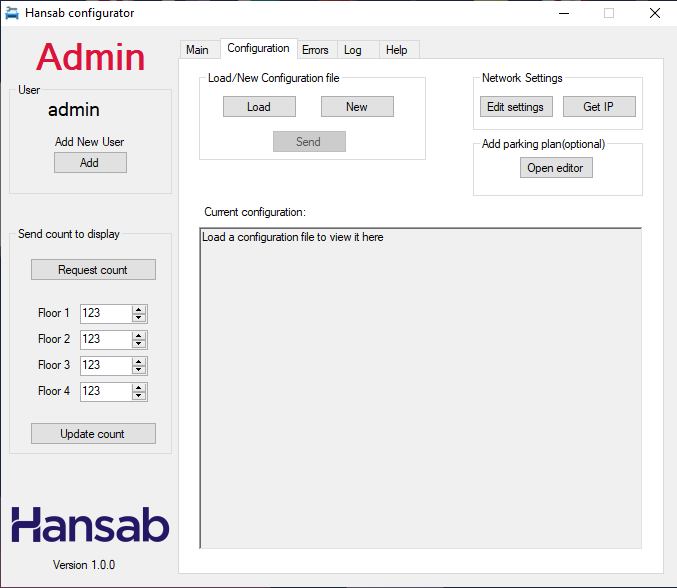
Parking Project/Images/Admin_Configuration_Page.png
