deskpro256/Hansab_parking_counter/Parking Project/Images/Admin_Errors.png

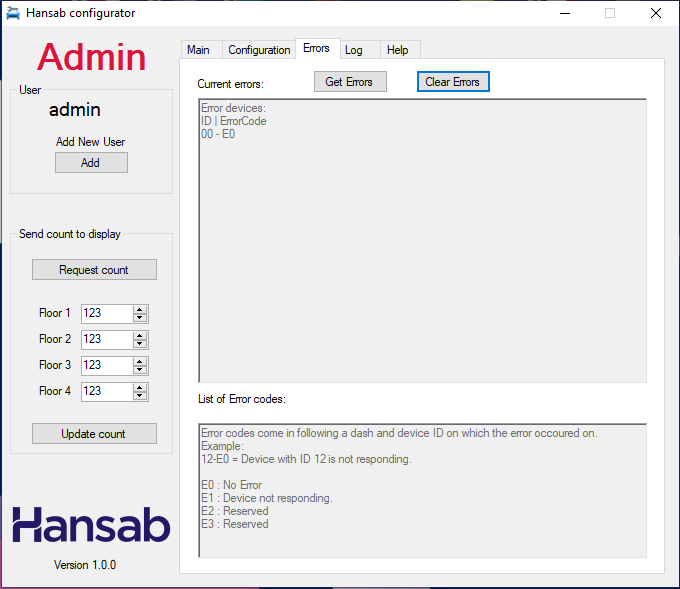
Parking Project/Images/Admin_Errors.png
