deskpro256/Hansab_parking_counter/Parking Project/Images/Admin_Help.png

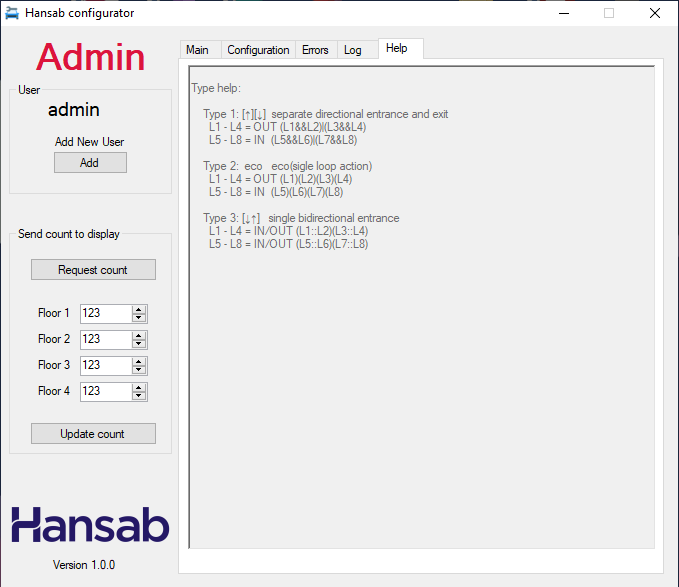
Parking Project/Images/Admin_Help.png
