deskpro256/Hansab_parking_counter/Parking Project/Images/Admin_Image_Editor_Empty.png

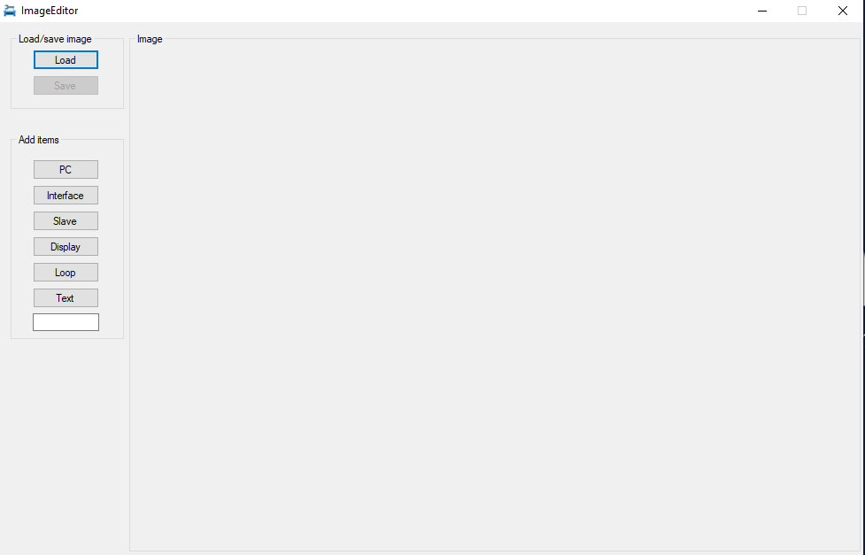
Parking Project/Images/Admin_Image_Editor_Empty.png
