deskpro256/Hansab_parking_counter/Parking Project/Images/Admin_Log.png

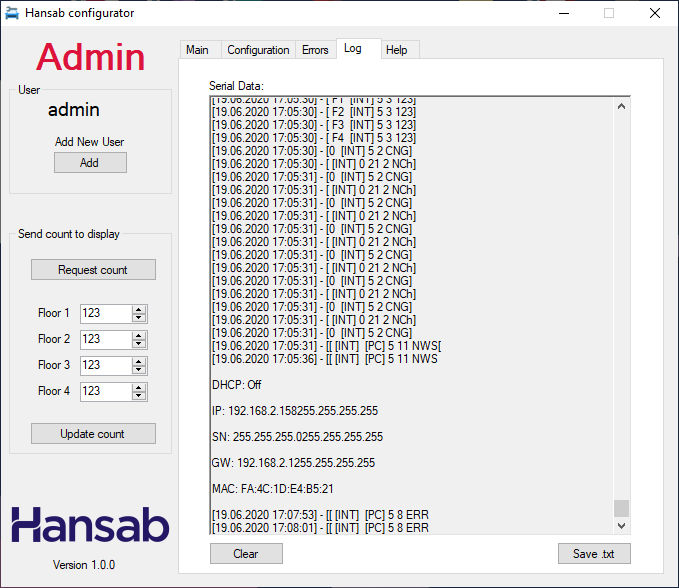
Parking Project/Images/Admin_Log.png
