deskpro256/Hansab_parking_counter/Parking Project/Images/Admin_main_detect_loaded-found.png

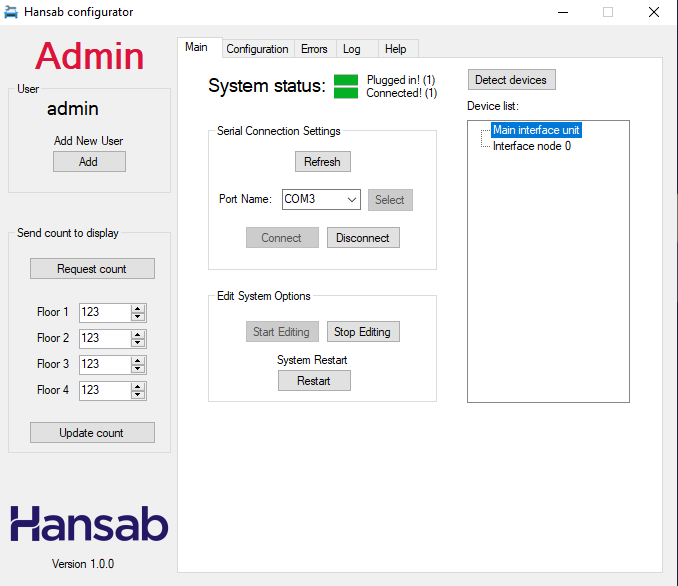
Parking Project/Images/Admin_main_detect_loaded-found.png
