deskpro256/Hansab_parking_counter/Parking Project/Images/Admin_main_detect_loading.png

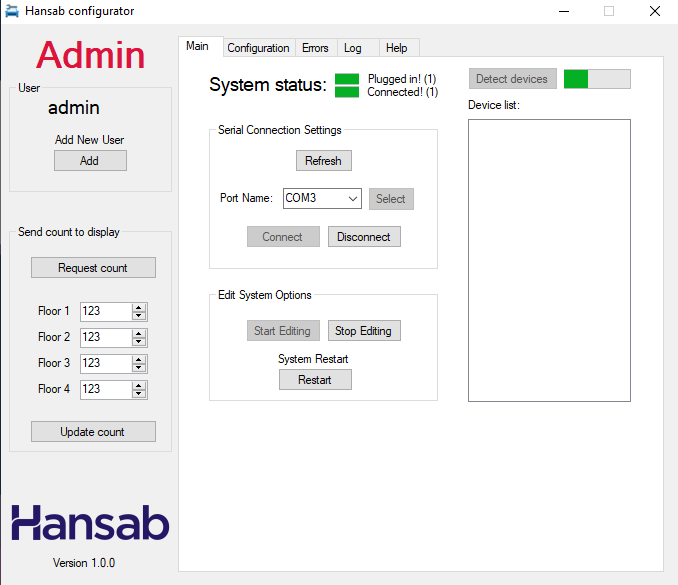
Parking Project/Images/Admin_main_detect_loading.png
