deskpro256/Hansab_parking_counter/Parking Project/Images/Admin_main_plugged-in.png

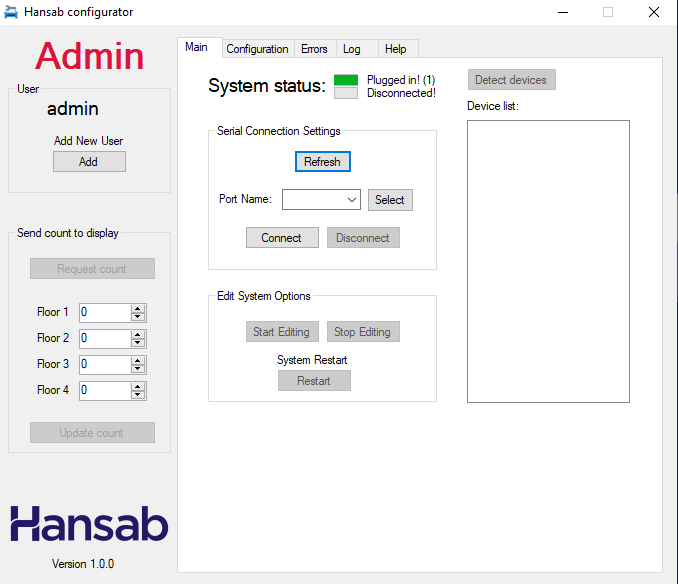
Parking Project/Images/Admin_main_plugged-in.png
