deskpro256/Hansab_parking_counter/Parking Project/Images/Admin_Network_Settings.png

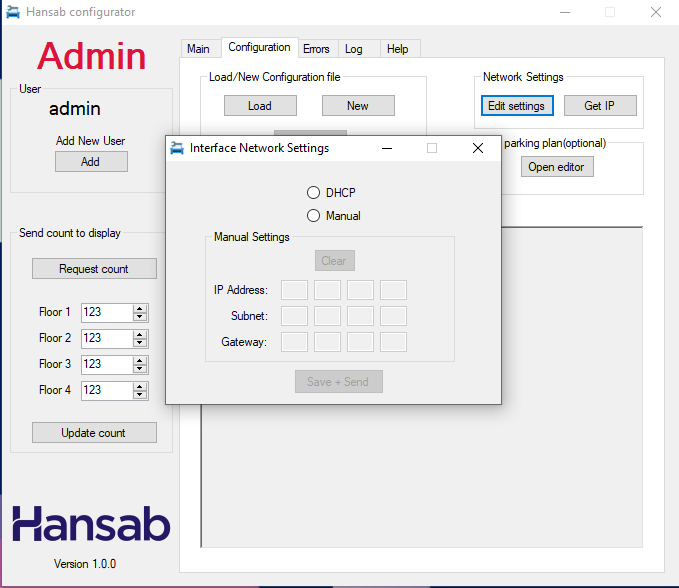
Parking Project/Images/Admin_Network_Settings.png
