deskpro256/Hansab_parking_counter/Parking Project/Images/Admin_Network_Settings_GetIP.png

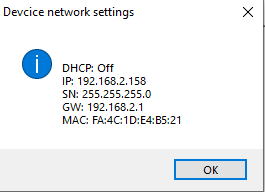
Parking Project/Images/Admin_Network_Settings_GetIP.png
