deskpro256/Hansab_parking_counter/Parking Project/Images/ForgotPassword.png

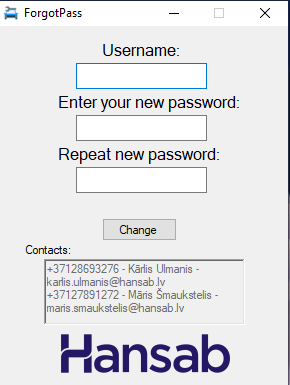
Parking Project/Images/ForgotPassword.png
