deskpro256/Hansab_parking_counter/Parking Project/Images/Login.png

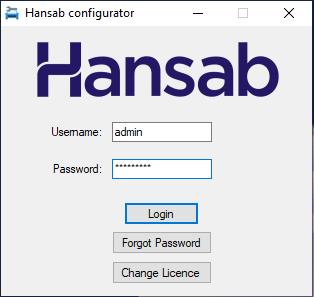
Parking Project/Images/Login.png
