deskpro256/Hansab_parking_counter/Parking Project/Images/WebPage_Current.png

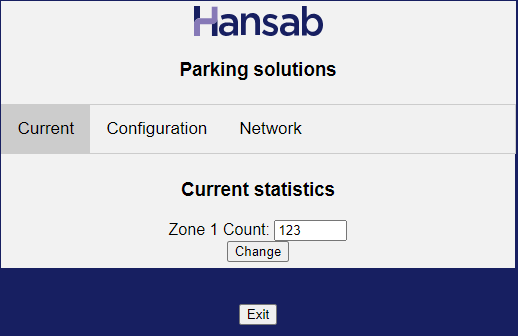
Parking Project/Images/WebPage_Current.png
