deskpro256/Hansab_parking_counter/Parking Project/Images/WebPage_Login.png

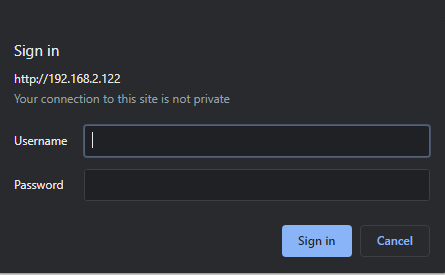
Parking Project/Images/WebPage_Login.png
