deskpro256/Hansab_parking_counter/Hardware/BOM/LCSC/REV3/Costs.xlsx

[Interface]
PCB prototypes (5gb): | 1.80 €
SMT Assembly(Soldering + SMD components): | 85.87 €
Total: |  | 87.65 €
[Slave]
PCB prototypes (5gb): | 3.56 €
SMT Assembly(Soldering + SMD components): | 56.86 €
Total: |  | 60.42 €
[Seperate components]
Components: | 20.30 €
Shipping (FedEx International 3-7 days): | 19.14 €
Total: |  | 39.44 €
[Soldering]
Manual soldering: 4h
[Import tax 15%]
Interface: 15%(87.65) |  | 13.15 €
Slave:15%(60.42) |  | 9.06 €
Components:15%(39.44) |  | 5.92 €
[Total] |  | 215.64 €
