deskpro256/Hansab_parking_counter/Hardware/BOM/LCSC/REV3/EasyEDA Exported/BOM_Interface_device.csv

ID | Name | Designator | Footprint | Quantity | Manufacturer Part | Manufacturer | Supplier | Supplier Part | LCSC Assembly
1 | TP8485E-SR | U3,U1 | SOIC-8 | 2 | TP8485E-SR | 3PEAK | LCSC | C94206
2 | SS34 | D3 | SMA(DO-214AC) | 1 | SS34 | MDD | LCSC | C8678
3 | 12MHz | X1 | OSC-SMD_4P-L3.2-W2.5-BL | 1 | X322512MSB4SI | YXC | LCSC | C9002 | Yes
4 | 1N4148WS-7-F | D2 | 1N4148WS-7-F_SOD323 | 1 | 1N4148WS T4 | CJ | LCSC | C2128
5 | 8MHz | X3 | OSC-SMD_L5.0-W3.2 | 1 | X50328MSB2GI | YXC | LCSC | C115962 | Yes
6 | LED-Green(0805) | USB | LED-0805 | 1 | 17-21SUYC/TR8 | Hubei KENTO Elec | LCSC | C2296
7 | LED-Red(0805) | RX | LED-0805 | 1 | 17-21SUYC/TR8 | Hubei KENTO Elec | LCSC | C2296
8 | 0.1uF | C7,C25,C20,C1,C6,C9,C10,C11,C12,C13,C23,C8,C5,C2,C26,C24 | 0603 | 16 | CC0603KRX7R9BB104 | YAGEO | LCSC | C14663
9 | 15p | C3,C4 | 0603 | 2 | CL10C220JB8NNNC | SAMSUNG | LCSC | C1653
10 | 22p | C28,C27 | 0603 | 2 | CL10C220JB8NNNC | SAMSUNG | LCSC | C1653
11 | DB125-3.81-2P | CN4 | CONN-TH_2P-P3.81_L7.4-W7.6 | 1 | DB125-3.81-2P | DIBO | LCSC | C395878
12 | 25MHz | X2 | OSC-SMD_4P-L3.2-W2.5-BL | 1 | X322525MOB4SI | YXC | LCSC | C9006 | Yes
13 | 220R | R15,R18,R19,R17,R20,R22,R21 | 0603 | 7 | 0603WAF2200T5E | UniOhm | LCSC | C22962
14 | 1k | R12,R10 | 0603 | 2 | 0603WAF1001T5E | UniOhm | LCSC | C21190
15 | 50R | R8,R7,R11,R9 | 0603 | 4 | 0603WAF499JT5E | UniOhm | LCSC | C23185
16 | 15uH | L1 | IND-SMD_L4.0-W4.0 | 1 | SNR4018K-150M | 3L COILS | LCSC | C326304
17 | 150Ω | L2 | L0603 | 1 | FCM1608KF-151T06 | TAITEC | LCSC | C155065
18 | 100uF | C22 | CAP-D5.0XH5.5 | 1 | VE-101M0J0505-TRO | Lelon | LCSC | C249463
19 | 10uF | C21 | CAP-D5.0XH5.5 | 1 | VE-100M1H0505-TRO | Lelon | LCSC | C249452
20 | W5500 | U4 | QFP-48_L7.0-W7.0-P0.50-LS9.0-BL | 1 | W5500 | WIZNET | LCSC | C32843 | Yes
21 | MCP16301T-I/CHY | U5 | SOT-23-6 | 1 | MCP16301T-I/CHY | MICROCHIP | LCSC | C57168
22 | USB-B-Female-90 | CN2 | USB-B_TH_BF90 | 1 | USB-BF90 | ValuePro | LCSC | C46392
23 | 10k | R4,R1,R2,R16,R14,R3,R5 | 0603 | 7 | 0603WAF1002T5E | UniOhm | LCSC | C25804
24 | 35K | R13 | 0603 | 1 | 0603WAF3302T5E | UniOhm | LCSC | C4216
25 | 120R | RT1 | 0603 | 1 | ?
26 | LM2937IMP-3.3/NOPB | U6 | SOT-223 | 1 | LM2937IMP-3.3/NOPB | Texas Instruments | LCSC | C140265 | Yes
27 | HR913550A | RJ1 | HR913550A | 1 | HR913550A | HANRUN | LCSC | C163507
28 | MCP2200-ISS | U2 | SSOP20 | 1 | MCP2200-I/SS | Microchip Tech | LCSC | C220000
29 | 1u | C18,C19 | 0603 | 2 | CL10A105KB8NNNC | SAMSUNG | LCSC | C15849
30 | 20pf | C16,C17 | 0603 | 2 | CL10B221KB8NNNC | SAMSUNG | LCSC | C1603
31 | 10nF | C15 | 0603 | 1 | 0603B103K500NT | FH | LCSC | C57112
32 | 6.8nF | C29,C30 | 0603 | 2 | 0603B682K500NT | FH | LCSC | C1631
33 | 4.7uF | C14 | 0603 | 1 | CL10A475KO8NNNC | SAMSUNG | LCSC | C19666
34 | 12.4K | R6 | R0603 | 1 | 0603WAF1242T5E | UniOhm | LCSC | C22865 | Yes
35 | LED-Green(0805) | TX,PWR,COM | LED-0805 | 3 | 17-21SURC/S530-A2/TR8 | Everlight Elec | LCSC | C131244
36 | LED-Red(0805) | ERR,CFG | LED-0805 | 2 | 17-21SURC/S530-A2/TR8 | Everlight Elec | LCSC | C131244
37 | SK24 | D4,D1 | SMA | 2 | SK24 | MOSPEC | LCSC | C138940
38 | ASMD1210-020 | F1 | 1210 | 1 | ASMD1210-020 | JDTFUSE | LCSC | C135346
39 | ESDA6V1L | TVS1 | SOT-23(SOT-23-3) | 1 | ESDA6V1L | SINO-IC | LCSC | C355258
40 | ATMEGA328P-AU | U7 | TQFP-32_7X7X08P | 1 | ATMEGA328P-AU | MICROCHIP | LCSC | C14877 | Yes
41 | DB125-3.81-3P | CN3 | CONN-TH_3P-P3.81_L7.4-W11.4 | 1 | DB125-3.81-3P | DIBO | LCSC | C395879
