deskpro256/Hansab_parking_counter/Hardware/BOM/LCSC/REV3/EasyEDA Exported/BOM_Slave_device.csv

ID | Name | Designator | Footprint | Quantity | Manufacturer Part | Manufacturer | Supplier | Supplier Part | LCSC Assembly
1 | TP8485E-SR | U4,U3 | SOIC-8 | 2 | TP8485E-SR | 3PEAK | LCSC | C94206
2 | SS34 | D2 | SMA(DO-214AC) | 1 | SS34 | MDD | LCSC | C8678
3 | 8MHz | X1 | OSC-SMD_L5.0-W3.2 | 1 | X50328MSB2GI | YXC | LCSC | C115962 | Yes
4 | 1N4148WS-7-F | D3 | 1N4148WS-7-F_SOD323 | 1 | 1N4148WS T4 | CJ | LCSC | C2128
5 | 0.1uF | C8,C9,C5,C2,C1,C16,C10,C11,C13,C12,C15,C14,C17 | 0603 | 13 | CC0603KRX7R9BB104 | YAGEO | LCSC | C14663
6 | DB125-3.81-2P | CN11,CN10,CN13,CN5,CN9,CN6,CN1,CN2,CN4,CN8,CN7,CN3,CN12 | CONN-TH_2P-P3.81_L7.4-W7.6 | 13 | DB125-3.81-2P | DIBO | LCSC | C395878
7 | 15uH | L1 | IND-SMD_L4.0-W4.0 | 1 | SNR4018K-150M | 3L COILS | LCSC | C326304
8 | 1TS002E-2500-2501 | RESET | KEY-SMD_L6.1-W3.7-P7.80-LS8.0 | 1 | 1TS002E-2500-2501 | HYP | LCSC | C255802
9 | 100u | C4 | CAP-D5.0XH5.5 | 1 | VE-101M0J0505-TRO | Lelon | LCSC | C249463
10 | 10u | C3 | CAP-D5.0XH5.5 | 1 | VE-100M1H0505-TRO | Lelon | LCSC | C249452
11 | MCP16301T-I/CHY | U1 | SOT-23-6 | 1 | MCP16301T-I/CHY | MICROCHIP | LCSC | C57168
12 | 120R | RT | 0603 | 1 | ? |  | LCSC
13 | 220R | R6,R2,R1,R7 | 0603 | 4 | 0603WAF2200T5E | UniOhm | LCSC | C22962
14 | 100R | R17,R15,R10,R12,R14,R16,R11,R13 | 0603 | 8 | 0603WAF1200T5E | UniOhm | LCSC | C22787
15 | 10k | R9,R4,R8,R5 | 0603 | 4 | 0603WAF1002T5E | UniOhm | LCSC | C25804
16 | 31.6K | R3 | 0603 | 1 | 0603WAF3302T5E | UniOhm | LCSC | C4216
17 | 22pF | C7,C6 | 0603 | 2 | CL10C220JB8NNNC | SAMSUNG | LCSC | C1653
18 | RED | ERR | LED-0805 | 1 | 17-21SURC/S530-A2/TR8 | Everlight Elec | LCSC | C131244
19 | LED-Red(0805) | ACT,COM | LED-0805 | 2 | 17-21SURC/S530-A2/TR8 | Everlight Elec | LCSC | C131244
20 | SK24 | D1 | SMA | 1 | SK24A | GOOD-ARK | LCSC | C174029
21 | DIP switchEI-04 | SW1 | DIP SWITCHEI-04 | 1 | DIP switchEI-04 | DIP | LCSC | C99987
22 | GRN | PWR | LED-0805 | 1 | 17-21/BHC-XL2M2TY/3T | Everlight Elec | LCSC | C72035
23 | ASMD1210-020 | F1 | 1210 | 1 | ASMD1210-020 | JDTFUSE | LCSC | C135346
24 | ESDA6V1L | TVS2,TVS6,TVS3,TVS4,TVS5,TVS1 | SOT23-3 | 6 | ESDA6V1L | SINO-IC | LCSC | C355258
25 | ATMEGA328P-AU | U2 | TQFP-32_7X7X08P | 1 | ATMEGA328P-AU | MICROCHIP | LCSC | C14877
