deskpro256/Hansab_parking_counter/Hardware/BOM/LCSC/REV3/LCSC Order/Combined_order.xlsx

LCSC Part Number | Customer # | Quoted Manufacturer | Quoted LCSC Part Number | Quantity | Unit Price | Quantity Available | Min\Mult Order Qty | RoHS | Part Match Confidence
C326304 |  | 3L COILS | C326304 | 5 | 0.091994 | 2970 | 5\5 | yes | 100%
C47207 |  | Cixi Tonver Elec | C47207 | 1 | 0.174793 | 10081 | 1\1 | yes | 100%
C395878 |  | DIBO | C395878 | 15 | 0.105055 | 20795 | 5\5 | yes | 100%
C255802 |  | HYP (Hongyuan Precision) | C255802 | 10 | 0.037457 | 35390 | 10\10 | yes | 100%
C46392 |  | Jing Extension of the Electronic Co. | C46392 | 5 | 0.075517 | 49890 | 5\5 | yes | 100%
C395879 |  | DIBO | C395879 | 1 | 0.160841 | 10610 | 1\1 | yes | 100%
C163507 |  | HANRUN(Zhongshan HanRun Elec) | C163507 | 1 | 0.785909 | 12298 | 1\1 | yes | 100%
C155065 |  | TAITEC | C155065 | 100 | 0.0028 | 11300 | 100\100 | yes | 100%
C138940 |  | MOSPEC Semicon | C138940 | 10 | 0.045451 | 4110 | 10\10 | yes | 100%
C94206 |  | 3PEAK | C94206 | 2 | 0.20475 | 33618 | 1\1 | yes | 100%
