deskpro256/Hansab_parking_counter/Parking Project/Images/Interface_w_components_Top.png

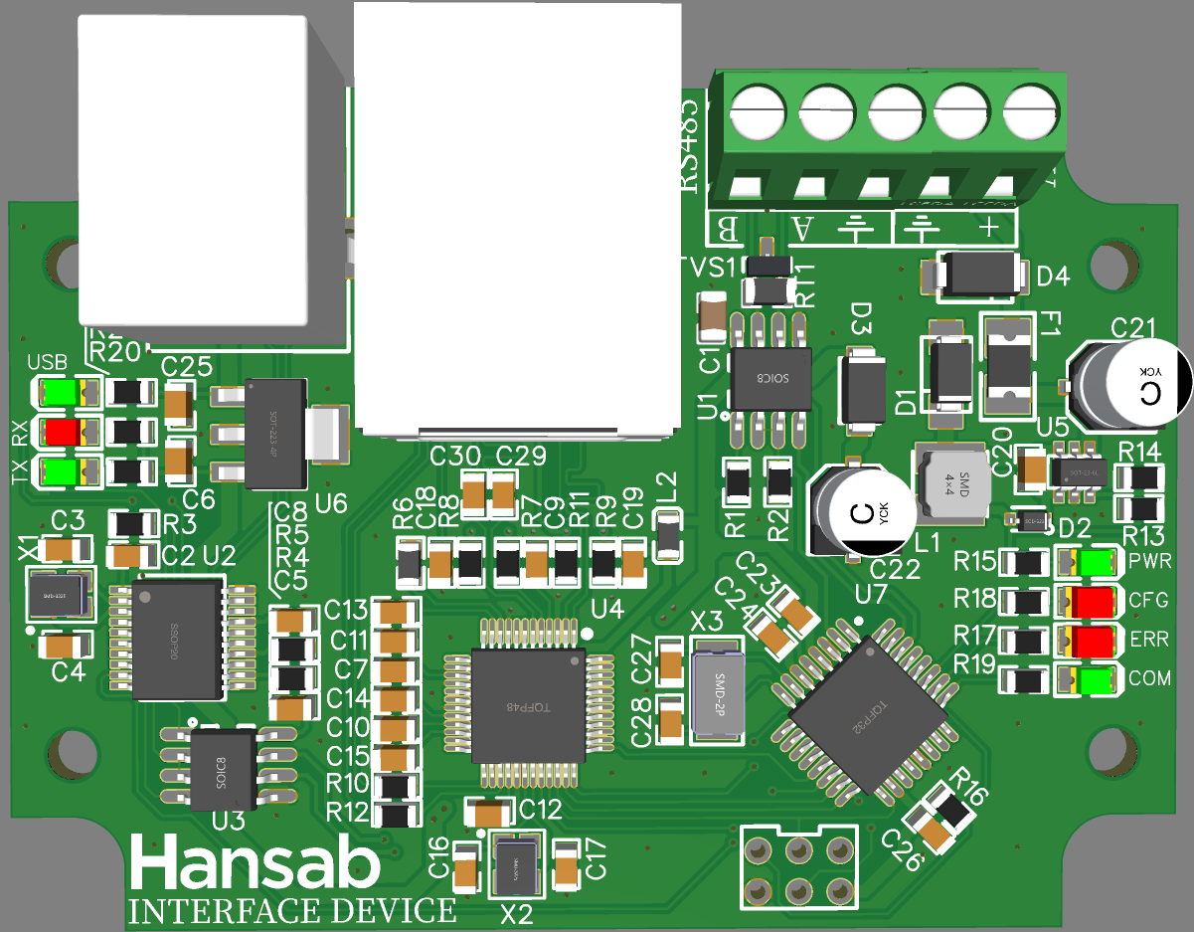
Parking Project/Images/Interface_w_components_Top.png
