deskpro256/Hansab_parking_counter/(list of files, cad)

Other CAD files:
Hardware/Case_Design/Gainta G1908/G1908.dwg
