deskpro256/Hansab_parking_counter/Parking Project/Installations/TestFeedback.xlsx

 | Stāvvietas brīvo vietu skaits: 213
26.marts 2020
 | 177/213 vietas uz displeja, reālais skaits: 156/213 | >> Kļūdains skaits radies pa dienu daudzo cilvēko staigāšanas dēļ
17:15:00 | ierados objektā, pārskaitīju esošos auto: 57. Tātad 213 -57 =156
17:16:00 | -1 | 155
17:19:00 | +1 | 156
17:20:00 | +1 | 157
17:23:00 | -1 | 156
17:26:00 | -1 ienāca 2 sievietes 1m attālumā viena no otras | 155
17:28:00 | +1 | 156
17:29:00 | +1 | 157
17:30:00 | -1 | 156
17:32:00 | +1 | 157
17:34:00 | +1 | 158
17:38:00 | -1 | 157
17:39:00 | +1 | 158
17:40:00 | +1 | 159
17:47:00 | -1 | 158
17:53:00 | +1 | 159
17:55:00 | Dodos prom no objekta, ekrānā 180/213 | Reālais skaits: 160, ignorējot tās 2 sievietes
