deskpro256/Hansab_parking_counter/Parking Project/Images/Admin_NewUser_TestUser.png

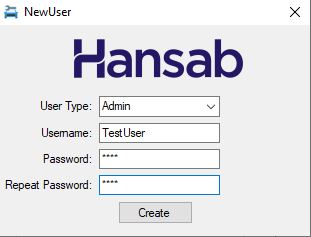
Parking Project/Images/Admin_NewUser_TestUser.png
