deskpro256/Hansab_parking_counter/Parking Project/Images/Admin_NewUser_TestUser_Created.png

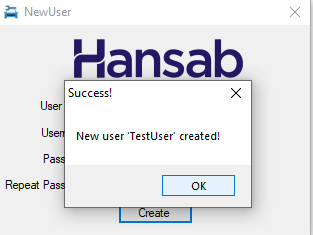
Parking Project/Images/Admin_NewUser_TestUser_Created.png
