deskpro256/Hansab_parking_counter/Parking Project/Installations/ConfiguratorTests/3.jpg

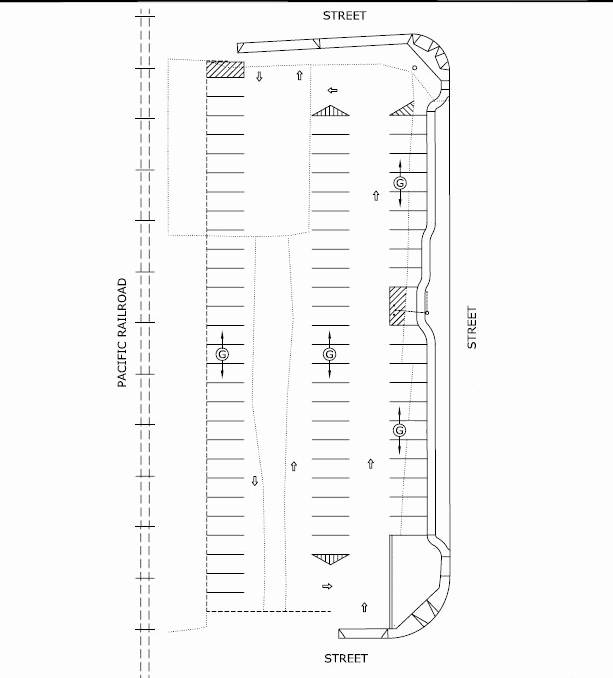
Parking Project/Installations/ConfiguratorTests/3.jpg
