deskpro256/Hansab_parking_counter/Parking Project/Installations/ConfiguratorTests/4.jpg

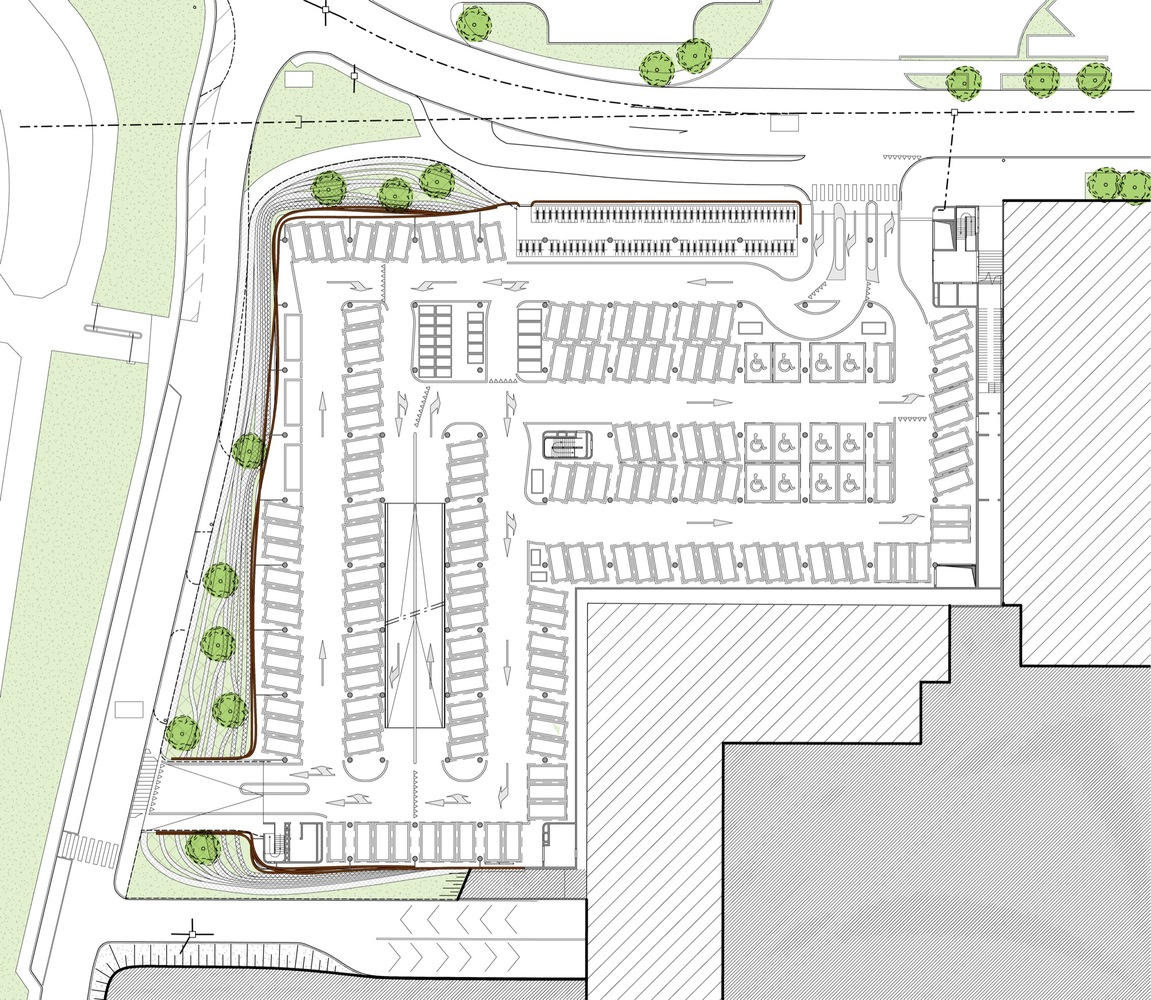
Parking Project/Installations/ConfiguratorTests/4.jpg
