deskpro256/Hansab_parking_counter/Documentation/Schematic/Connecting_diagram.pdf

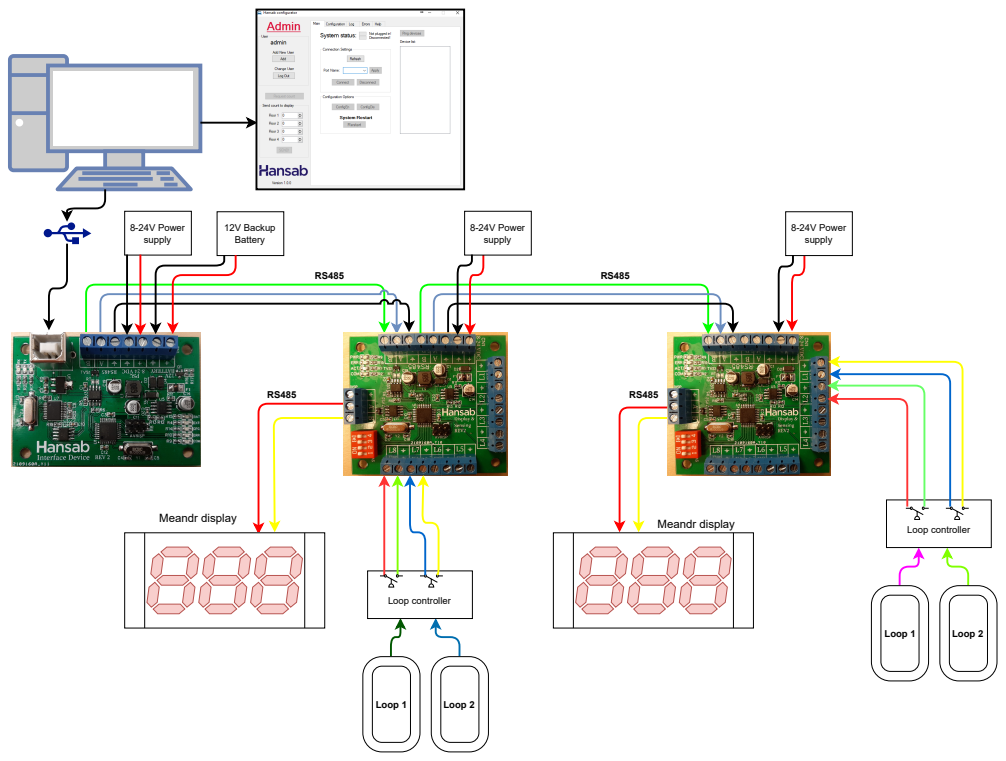
[picture p74: page 1]
Loop 1; Loop 2; 8-24V Power supply; Loop controller; 12V Backup Battery; Meandr display
