deskpro256/Hansab_parking_counter/Parking Project/Installations/ConfiguratorTests/JekabaArkadeConnections.pdf

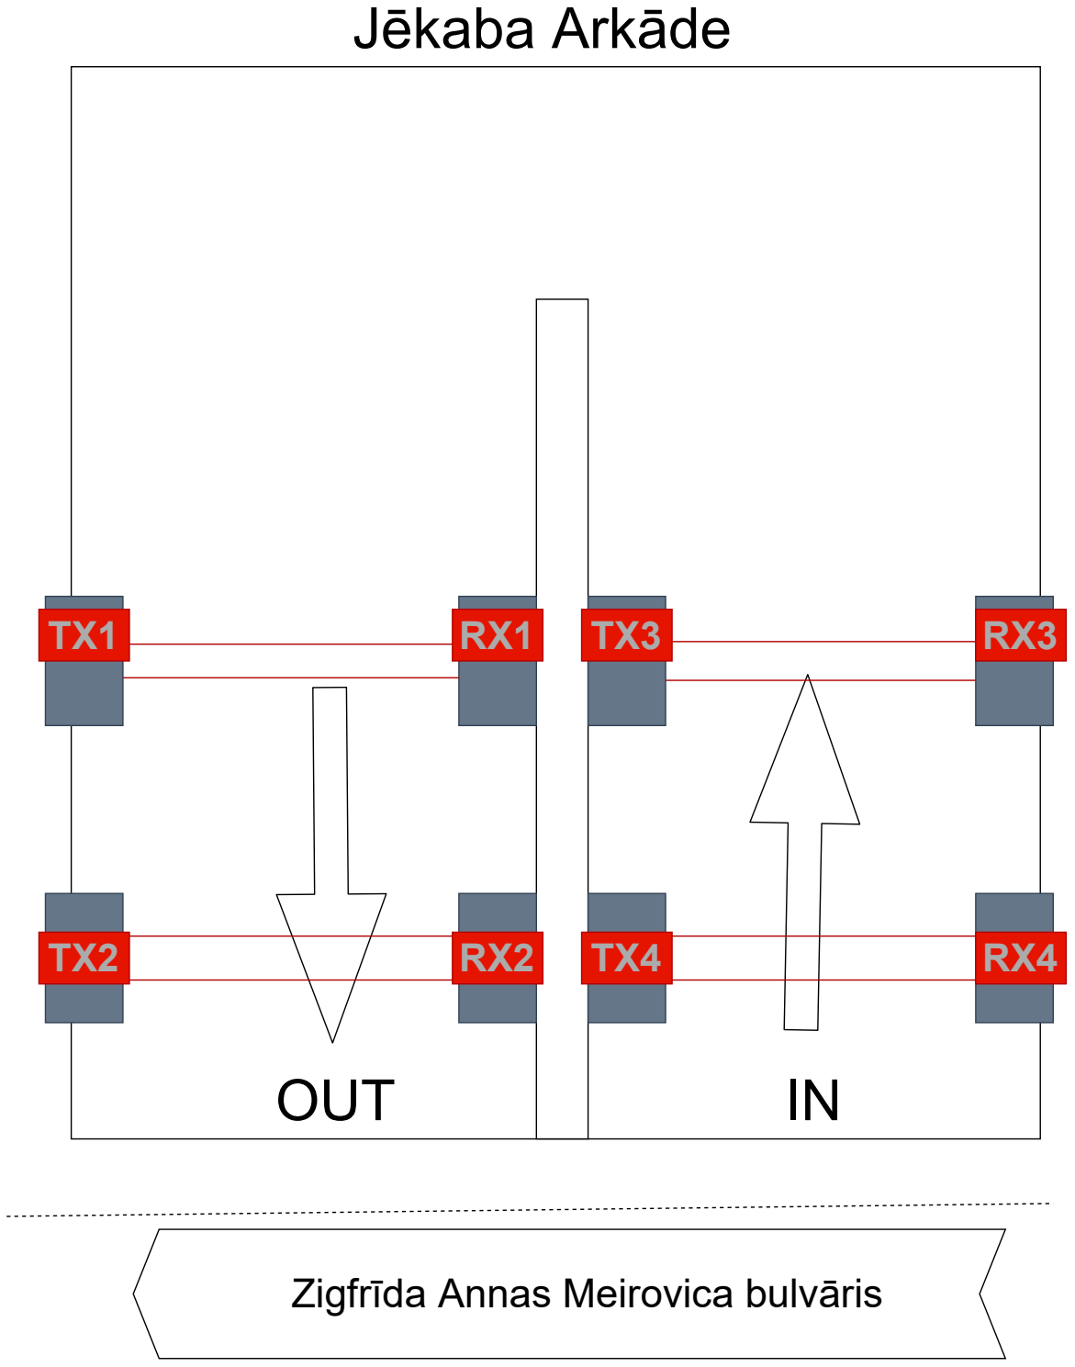
[picture p75: figure]
Jēkaba Arkāde; Zigfrīda Annas Meirovica bulvāris; OUT

# USB

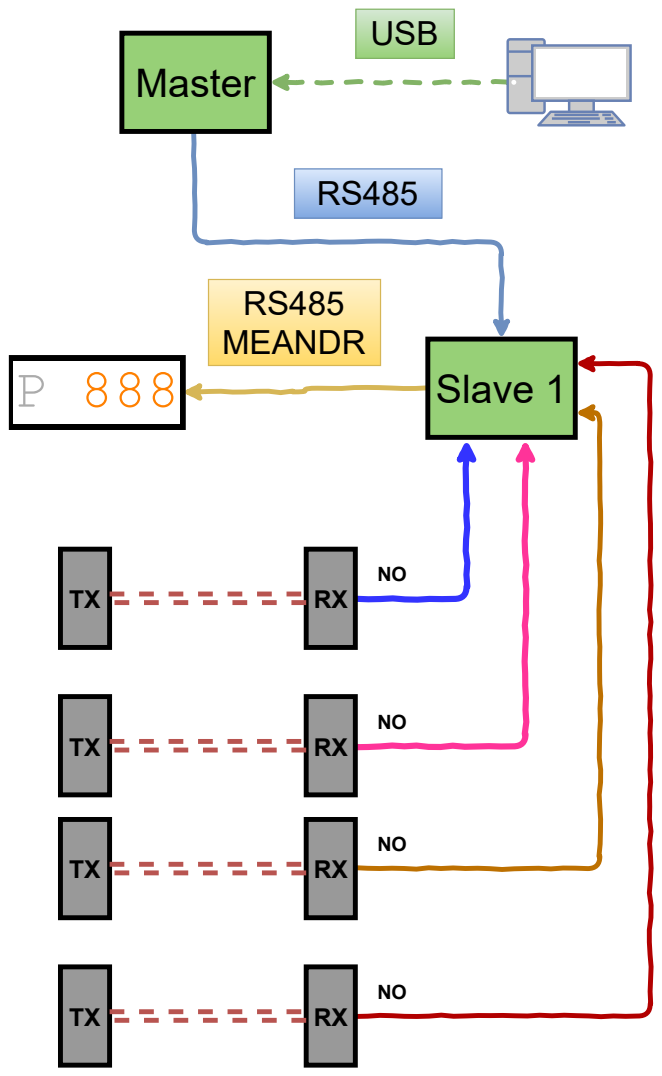
[picture p76: page 2]
Master; Slave 1; RS485 MEANDR

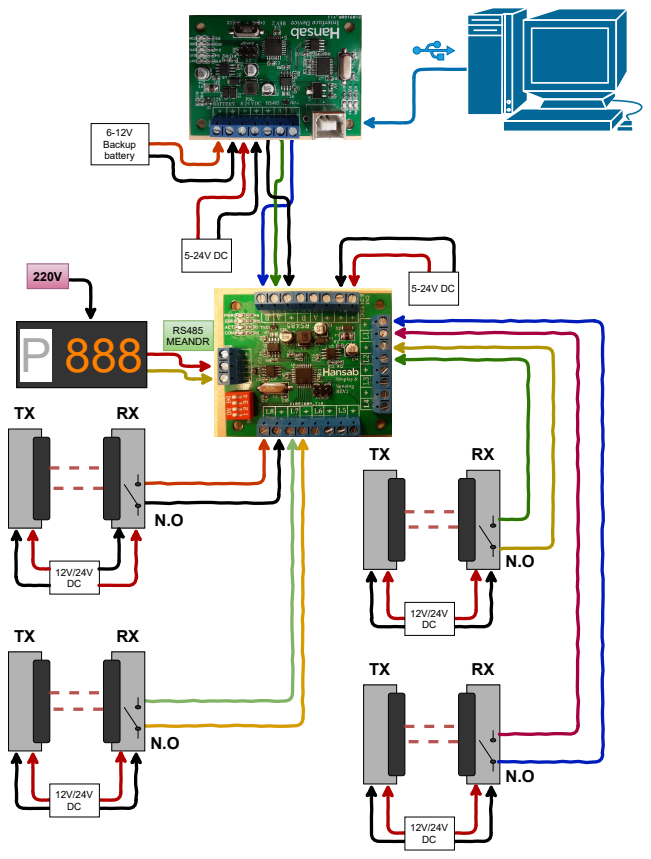
[picture p77: page 3]
6-12V Backup battery; RS485 MEANDR
