deskpro256/Hansab_parking_counter/Documentation/Slave/REV3/Slave_device_schematic.pdf

MICROCONTROLLER CIRCUIT | STATUS LEDS

## EXTERNAL POWER

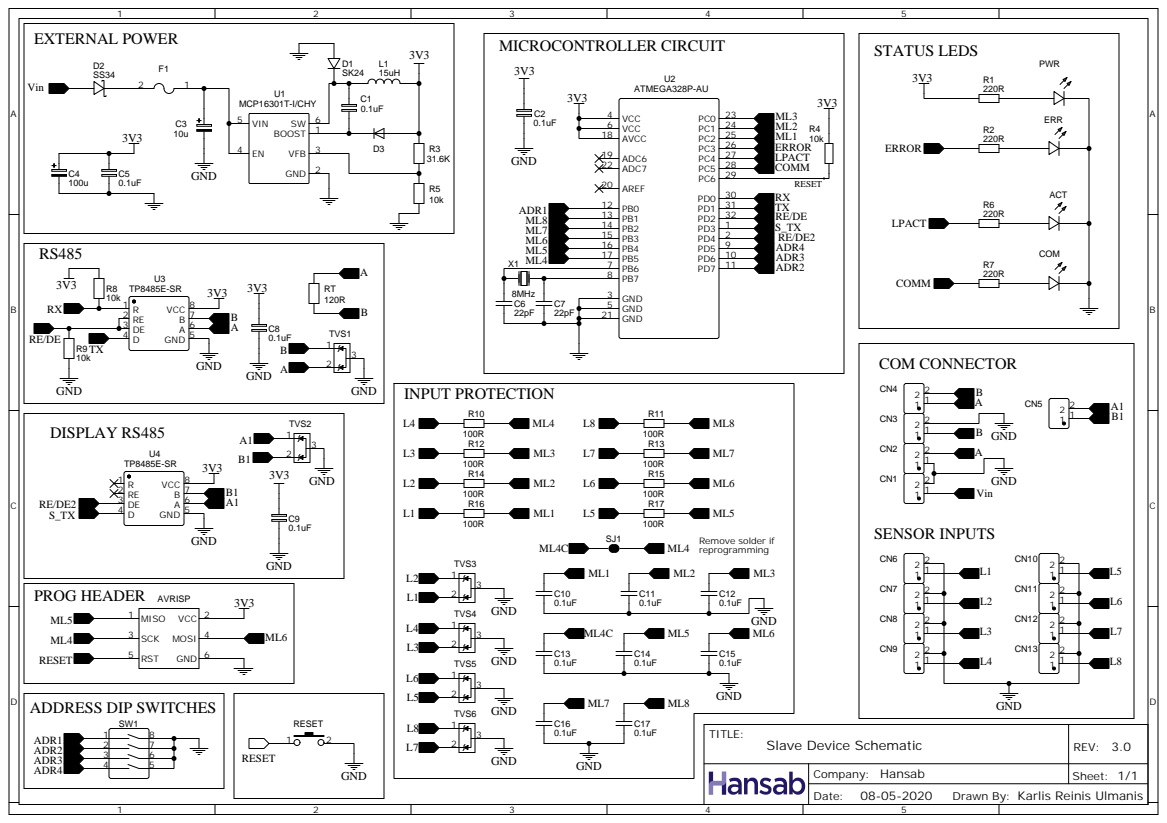
[picture p78: page 1]

Drawn By: Karlis Reinis Ulmanis
