deskpro256/Hansab_parking_counter/Documentation/Interface/REV3/Interface_device_schematic.pdf

3V3A

3V3A

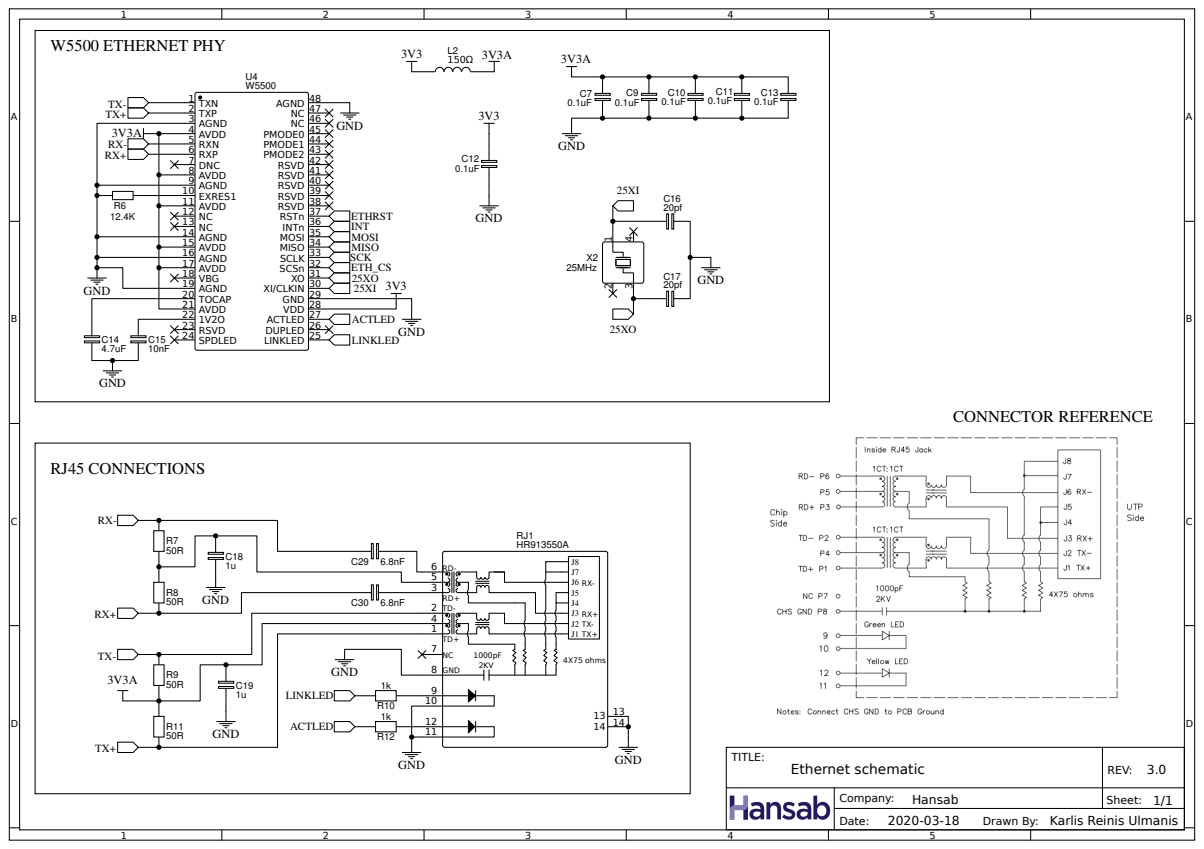
[picture p79: page 1]

Drawn By: Karlis Reinis Ulmanis

# INDICATION LEDS

## GND

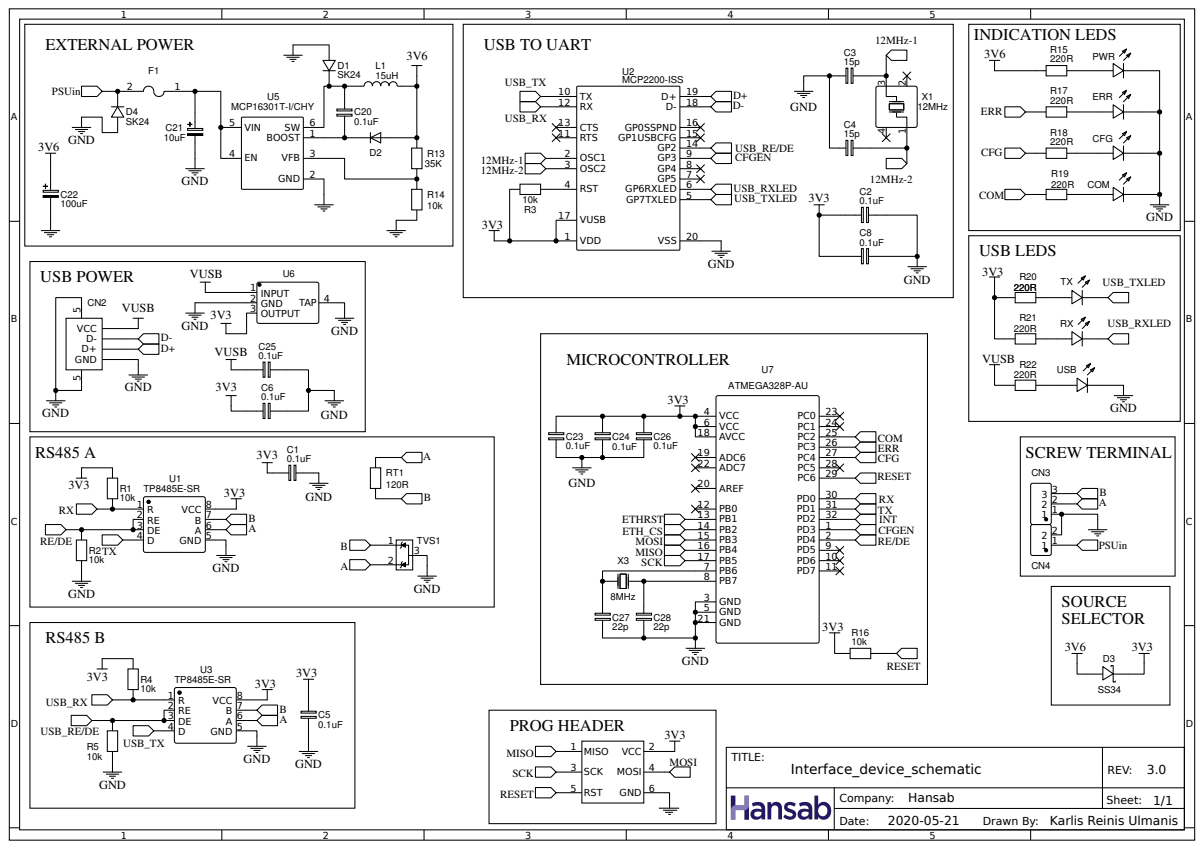
[picture p80: page 2]

Drawn By: Karlis Reinis Ulmanis
