deskpro256/Hansab_parking_counter/Hardware/Schematics/Slave_device_schematic.pdf

3V3
3V3

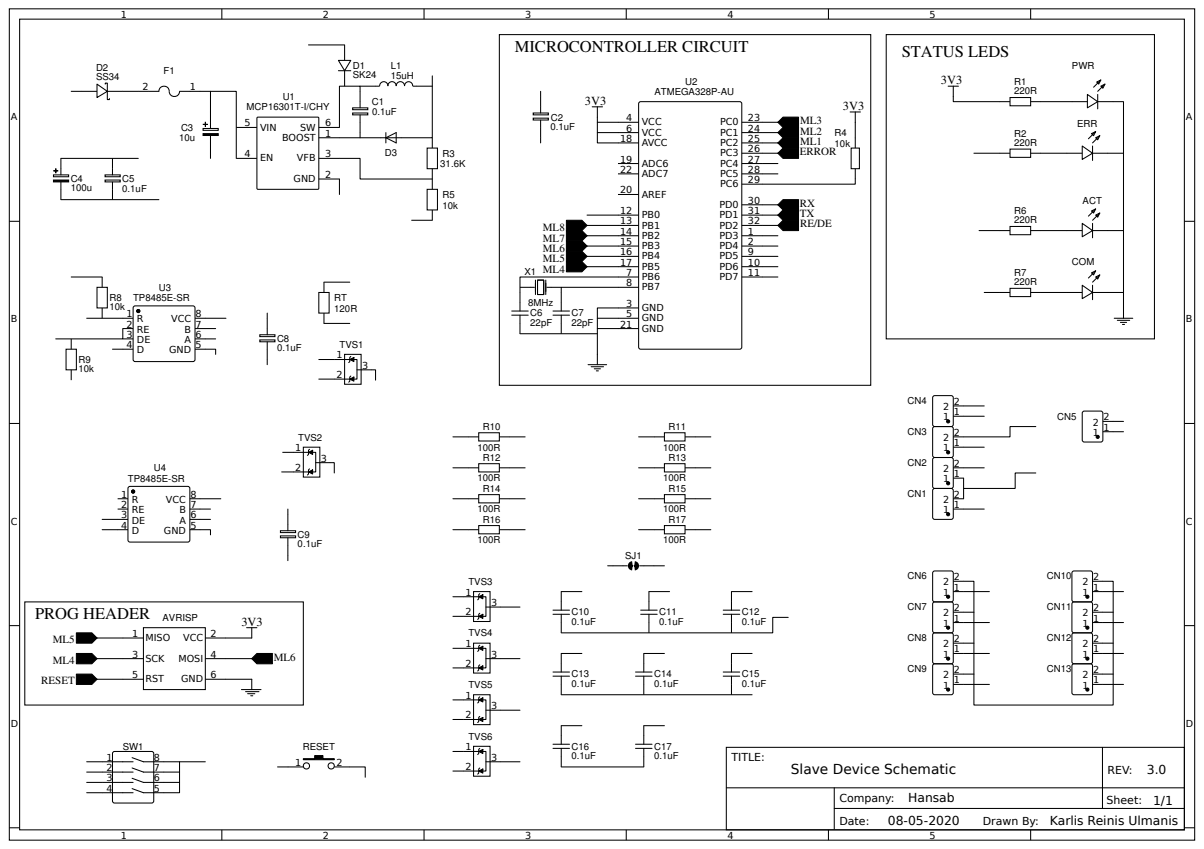
[picture p81: page 1]

Drawn By: Karlis Reinis Ulmanis
