deskpro256/Hansab_parking_counter/Hardware/Case_Design/Gainta G1908/G1908.pdf

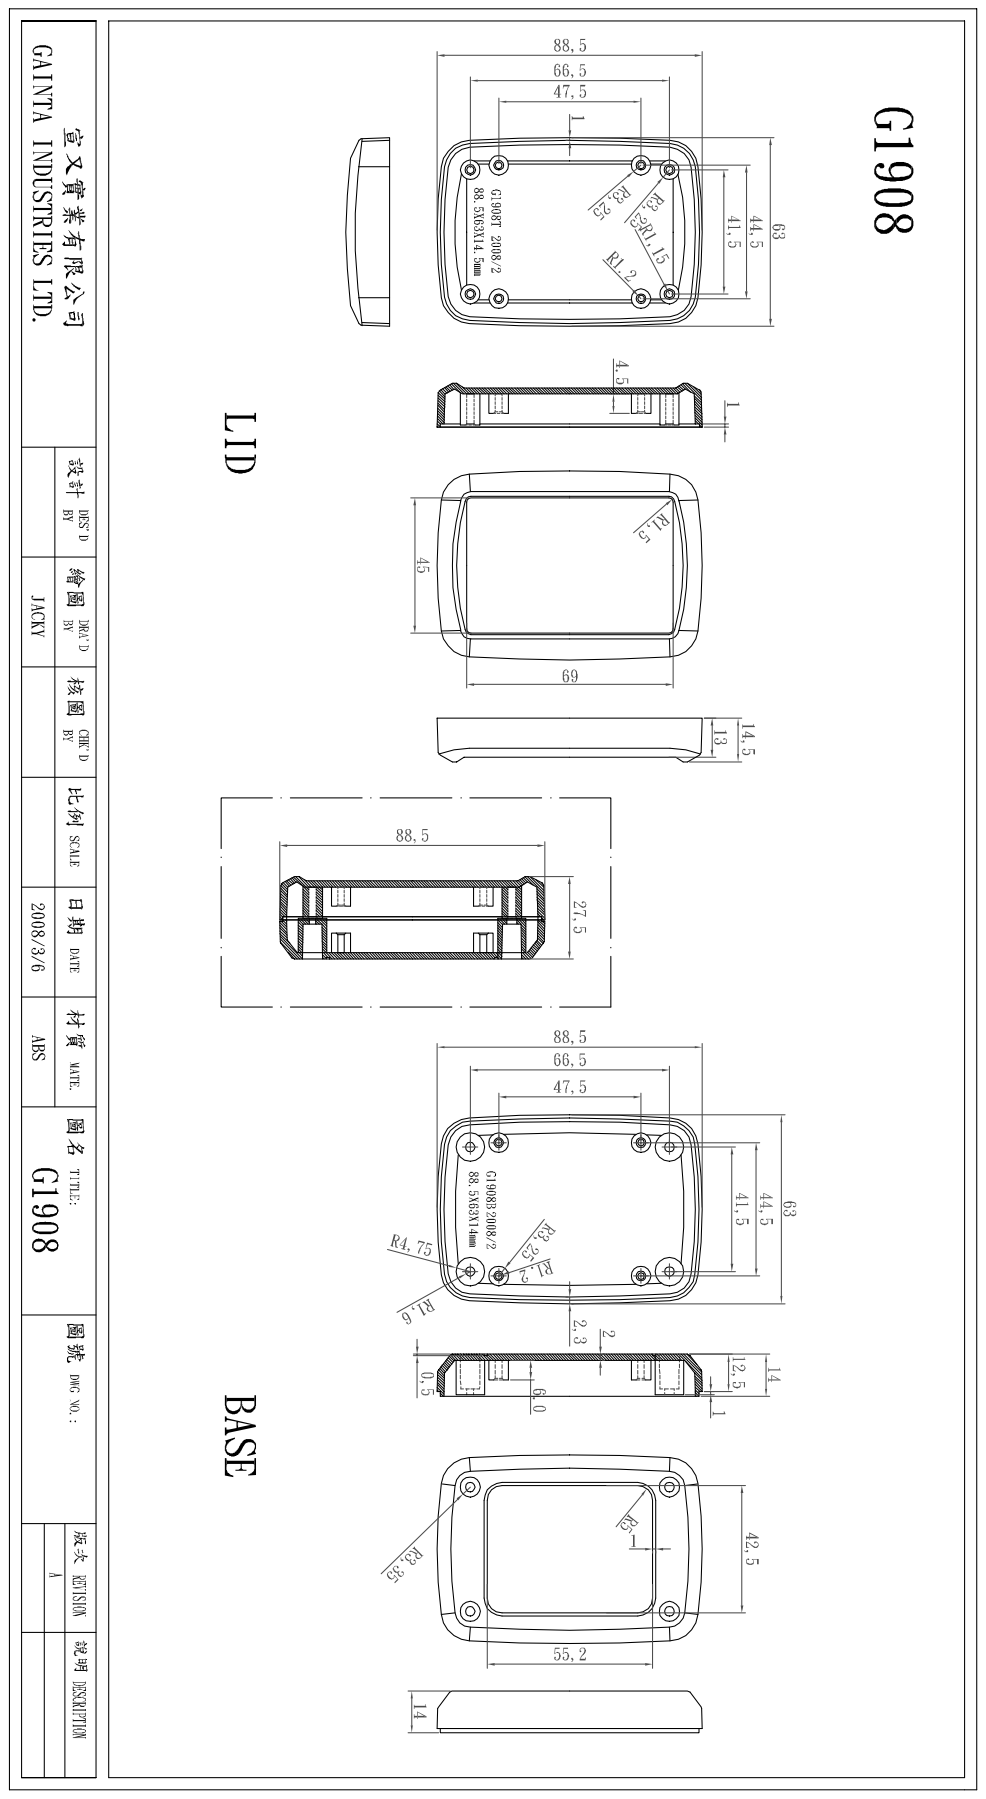
[picture p82: page 1]
