deskpro256/Hansab_parking_counter/Parking Project/Installations/ConfiguratorTests/Schematic/Simplified_Setup.pdf

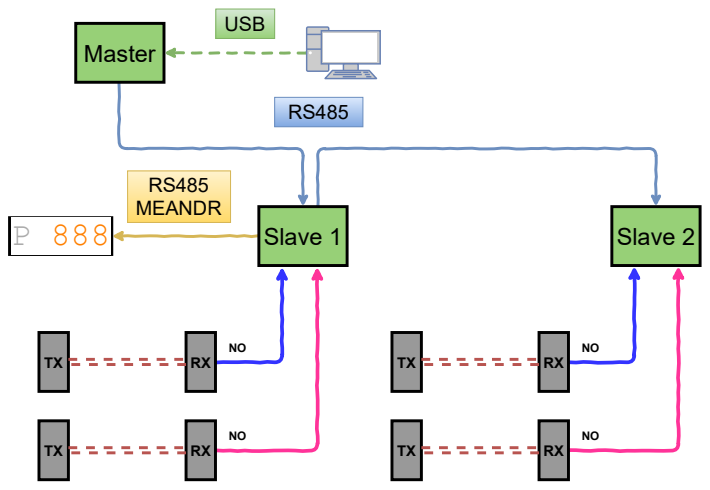
[picture p83: page 1]
Master; Slave 1; Slave 2; USB; RS485 MEANDR
