deskpro256/Hansab_parking_counter/Documentation/Interface/REV2/Schematic_interface.pdf

## BACKUP BATTERY SELECTOR

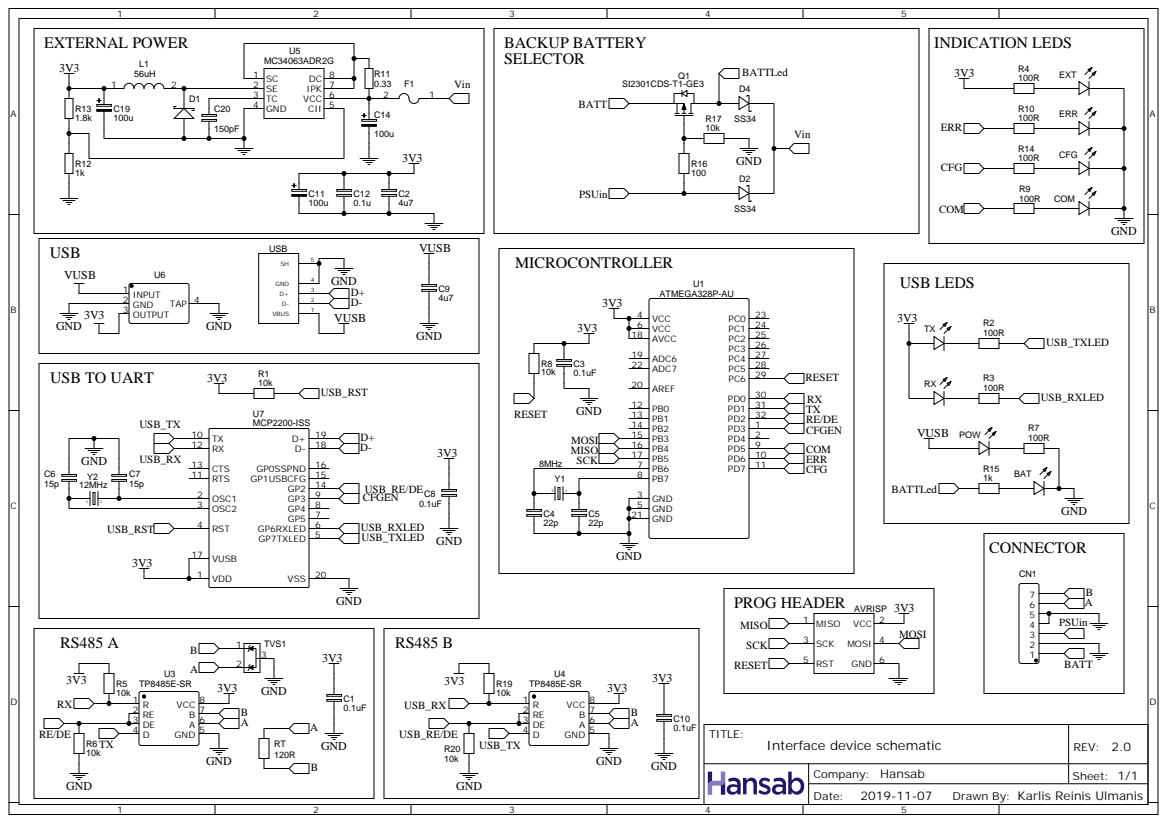
[picture p84: page 1]

Drawn By: Karlis Reinis Ulmanis
