deskpro256/Hansab_parking_counter/Documentation/Slave/REV2/Schematic_slave.pdf

MICROCONTROLLER CIRCUIT | STATUS LEDS

## EXTERNAL POWER

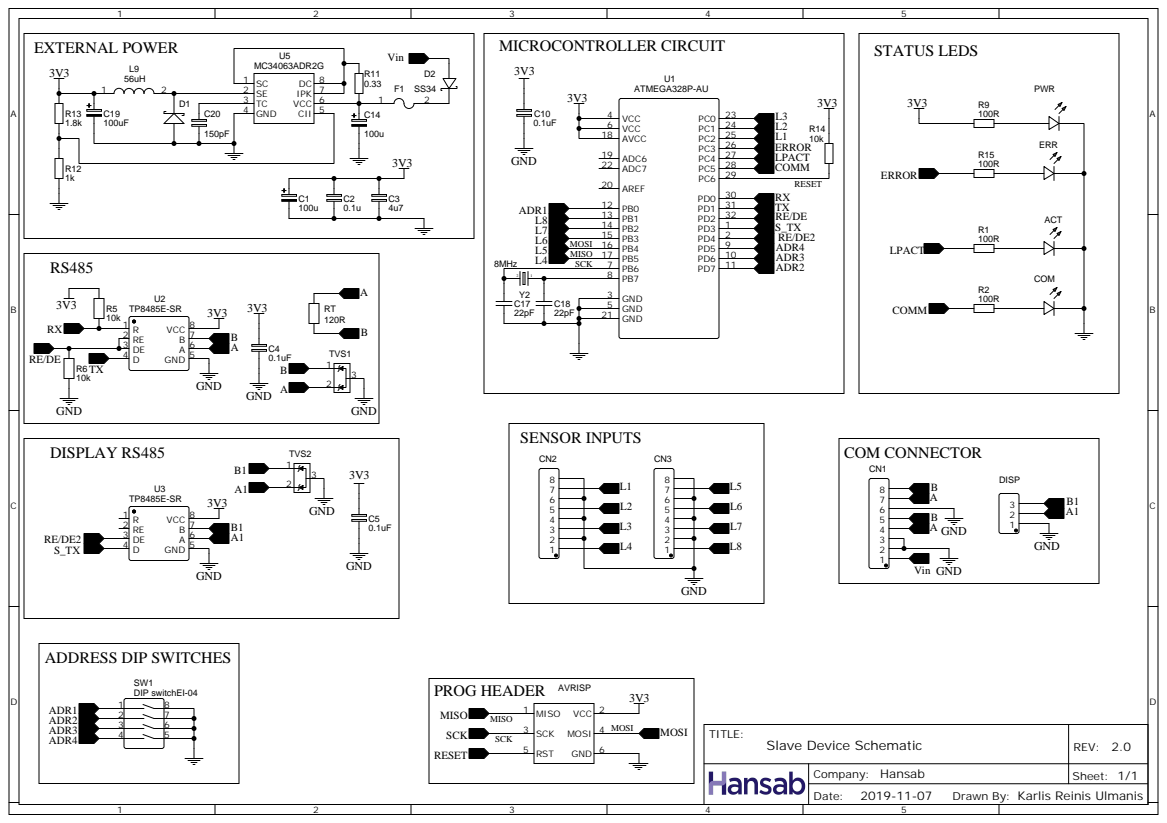
[picture p85: page 1]

Drawn By: Karlis Reinis Ulmanis
