deskpro256/Hansab_parking_counter/Firmware/Counter_slave_program/CMD.ino

//char CMDLUT[] = {
// 0x01 - getErrors
// 0x02 - getChanges
// 0x03 - sendDisplayCount
// 0x04 - clearErrors
// 0x05 - firstTimeSetup
// 0x06 - ping/pong
// 0x07 - sendDisplayCountToUSB
// 0x08 - sendErrorReport
// 0x09 - restart
// 0x0A - networkSettings
// 0x0B - sendNWSettings
// 0x0C - sendMACSettings
// };     a look up table for every command

//char messageType[] = {
//                      0x05 - ENQ
//                      0x06 - ACK
//                      0x21 - NAK
//};                     a look up table for every messageType

//============================[GET_CMD_NAME]========================
// gets the command byte from the message and executes the corresponding func
void getCMD(char cmd, char msgType, char onesN, char tensN, char hundredsN) {
  wdt_reset();

  //--------------------------------------
  if (cmd == CMDLUT[0]) {  // 0x01 - getErrors
    if (errorState) {
      //sendErrorReport(errorCount);
      RS485Send(0x1D, messageType[2], CMDLUT[0], 'N', 'E', 'r');
    } else {
      RS485Send(0x1D, messageType[2], CMDLUT[0], 'N', 'E', 'r');
    }
  }
  //--------------------------------------
  if (cmd == CMDLUT[1]) {  // 0x02 - getChanges
    if (countChanged == true) {
      RS485Send(RXID, messageType[1], CMDLUT[1], inOut, changedCount, floorID);
      oldCount = count;
      countChanged = false;
    }
    else {
      RS485Send(RXID, messageType[2], CMDLUT[1], 'N', 'C', 'h');
    }
  }
  //--------------------------------------
  if (cmd == CMDLUT[2]) { // 0x03 - sendDisplayCount

    displayCount = ((hundredsN - '0') * 100) + ((tensN - '0') * 10) + (onesN - '0');
    count = displayCount;
    oldCount = count;
    drawDisplay(onesN, tensN, hundredsN);
  }
  //--------------------------------------
  if (cmd == CMDLUT[3]) { // 0x04 - clearErrors
    errorState = false;
    errorCount = 0;
  }
  //--------------------------------------
  if (cmd == CMDLUT[4]) { // 0x05 - firstTimeSetup
    ReceiveConfig();
    readEEPROMSettings();
    SW_Reset();
  }
  //--------------------------------------
  if (cmd == CMDLUT[5]) { // 0x06 - ping/pong
    RS485Send(0x1C, messageType[1], 'P', 'O', 'N', 'G');
  }
  //--------------------------------------
  if (cmd == CMDLUT[6]) { // 0x07 - request count from pc
    //do nothing
  }
  //--------------------------------------
  if (cmd == CMDLUT[7]) { // 0x08 - sendErrorReport
    //do nothing
  }
  //--------------------------------------
  if (cmd == CMDLUT[8]) { // 0x09 - restart

    SW_Reset();
  }
  //--------------------------------------
  if (cmd == CMDLUT[9]) { // 0x0A - networkSettings
    //do nothing
  }
  //--------------------------------------
  if (cmd == CMDLUT[10]) { // 0x0B - sendNWSettings
    //do nothing
  }
  //--------------------------------------
  if (cmd == CMDLUT[11]) { // 0x0C - sendMACsettings
    //do nothing
  }
}
