deskpro256/Hansab_parking_counter/Firmware/Counter_slave_program/Addressing.ino

//============================[GET_MY_ADDRESS]========================
// reads the DIP switches and translates that to an address for RS485 communication protocol
void getMyID() {
  wdt_reset();
  int adrINT;     //varialble to store slave's address as an int
  int DIP[4];     //array to store the SW1 DIP switch states
  //reading the states of SW1
  for (int i = 0; i <= 3 ; i++) {
    if (digitalRead(ADRLUT[i]) == HIGH) {
      DIP[i] = 1;
    }
    else {
      DIP[i] = 0;
    }
  }
  //takes the values of DIP and adds it up in a 4 bit "byte",then turns it into an integer
  adrINT = (DIP[0] * 8) + (DIP[1] * 4) + (DIP[2] * 2) + (DIP[3] * 1);
  //adrINT to ascii
  myID = adrINT;
}
