deskpro256/Hansab_parking_counter/Parking Project/Eth test/Ethernet/AMain/ISR.ino

//============================[ISR]==========================================================

ISR(INT1_vect) {
  if (PIND & (1 << PD3)) {
    PORTD |= (1 << PD7);      // Enable CFG Led
    ConfigEnabled = true;
    //configurationMode();
  }
  else {
    PORTD &= ~(1 << PD7);     // Disable CFG Led
    ConfigEnabled = false;
  }
}
