deskpro256/Hansab_parking_counter/(commit log)

2019-04-05 first commit,adding all work files
    [BOM_parking.xlsx]
2019-04-11 code revisions, interrupt routines
2019-07-10 removed unneeded files
    [BOM_parking.xlsx]
2019-08-01 updates to code, as well as interface
    [BOM_Parking_lot_interface_device.xlsx, BOM_Parking_lot_slave_device.xlsx]
2019-08-06 updates to code, both devices
2019-10-25 various updates to protocol, loop sensor inputs detection etc
    [Interface_EEPROM.xlsx, Slave_EEPROM.xlsx]
2019-11-01 Code updates, bug fixes, sends count difference to master, master calculates total, sends count to the entire floor GG
    [Addressing.ino, CMD_stuff.ino, Counter_slave_program.ino, Counting.ino, Display_driving.ino, EEPROM_Settings.ino, Errors.ino, Interface_program.ino]
2019-11-07 updated schematics and PCb files. Gerbers and schematics added. BOM list added.
    [BOM_Interface.xlsx, BOM_Parking_lot_interface_device.xlsx, BOM_Parking_lot_slave_device.xlsx, BOM_Slave.xlsx]
2019-11-11 added invoices
    [BOM_Interface.xlsx, BOM_Slave.xlsx, PickAndPlace_Interface_device_PCB_20191108094402.csv, PickAndPlace_Slave_Device_PCB_20191108094423.csv]
2019-11-25 added ability to send count to and from PC soft, various other bugfixes
    [CMD_stuff.ino, Counter_slave_program.ino, Counting.ino, Errors.ino, Interface_program.ino]
2019-11-29 EEPROM updates, preparing for config byte receiving from PC soft
    [Configuration.xlsx, Interface_EEPROM.xlsx, Slave_EEPROM.xlsx]
2019-12-03 added reset after EEPROM read
    [Configuration.xlsx, Interface_EEPROM.xlsx, Slave_EEPROM.xlsx]
2019-12-05 Updates to code, fixed communication error by extending sending data timing
    [7SegmentDisplay.ino, CMD.ino, Counting.ino, Errors.ino, Interface_program.ino, RS485.ino]
2020-01-02 updates, simple bug fixes
    [CMD.ino, Config.ino, Configuration.ino, Counter_slave_program.ino, Counting.ino, EEPROM_Settings.ino, Errors.ino, Interface_program.ino]
2020-01-13 fixed a lot of bugs, first time configuring, other small changes
    [CMD.ino, Counting.ino, EEPROM_Settings.ino, Errors.ino, Interface_program.ino, RS485.ino]
2020-01-17 fixed getting current count from pc soft, other led bugs
    [CMD.ino, Counting.ino, Display_driving.ino, EEPROM_Settings.ino, Errors.ino, ISR.ino, Interface_program.ino, RS485.ino]
2020-01-22 Interface device firmware updates, fixing error collection and other small fixes
    [CMD.ino, Counting.ino, Errors.ino]
2020-01-31 fixed wrong count possibility for master,other small fixes
    [Counting.ino, Errors.ino, Interface_program.ino]
2020-02-10 Added watchdog reset for SWreset()
    [BOM_Interface.xlsx, BOM_Interface_REV3.csv, BOM_Slave.xlsx, BOM_Slave_REV3.csv, Parking_project_costs.xlsx, PickAndPlace_Interface_device_PCB_20200206160927.csv, PickAndPlace_Slave_Device_PCB_20200206160854.csv]
2020-02-18 Fixed WDT reset
    [BOM_Interface_REV3.csv, BOM_Slave_REV3.csv]
2020-02-24 fixed error when '=' caused to act as a '+'
    [BOM_Interface_REV3.csv, InterfaceBOM.xlsx, PickAndPlace_Interface_device_PCB_20200206160927.csv, PickAndPlace_Slave_Device_PCB_20200206160854.csv, SlaveBOM.xlsx]
2020-03-02 fixed problem where inputs at the same time cancel out; Updated master number updating, various other fixes
    [CMD.ino, Counter_slave_program.ino, Counting.ino, ISR.ino, Interface_program.ino]
2020-06-03 updated images, documentation and case design files
    [Interface_device_PCB_2020-05-10_03-21-01.dxf, RL6105-FBK.dwg, RL6105-FBK.stp, RL6105-FBK.x_t, Slave_Device_PCB_2020-05-10_03-51-57.dxf]
2020-06-09 some fixes to the HTML file, also, need to look at the DHCP setting
    [Interface_program.ino]
2020-06-09 minor fix to html file
    [EEPROM_Settings.ino]
2020-06-19 Restructured folders
    [BOM_Interface.xlsx, BOM_Interface_REV3.csv, BOM_Parking_lot_interface_device.xlsx, BOM_Parking_lot_interface_device_2020-06-19_09-37-42.csv, BOM_Parking_lot_slave_device.xlsx, BOM_Parking_lot_slave_device_2020-06-18_10-42-12.csv, BOM_Slave.xlsx, BOM_Slave_Device.xlsx]
2020-06-22 updates to code, MAC change and EEPROM saving
    [BOM_Interface_REV3.csv, BOM_Interface_device.csv, BOM_Parking_lot_interface_device.xlsx, BOM_Parking_lot_interface_device_2020-06-19_09-37-42.csv, BOM_Parking_lot_slave_device.xlsx, BOM_Parking_lot_slave_device_2020-06-18_10-42-12.csv, BOM_Slave_Device.xlsx, BOM_Slave_REV3.csv]
2020-12-10 addind code updates etc to work from home
    [G1908.dwg, Interface_device_PCB_2020-05-10_03-21-01.dxf, RL6105-FBK.dwg, RL6105-FBK.stp, RL6105-FBK.x_t, Slave_Device_PCB_2020-05-10_03-51-57.dxf]
2020-12-10 added the WIP folder to this repo for update list and other junk
    [NewConfig.dat_Readable.txt, NewConfig4Floors.dat_Readable.txt, Parking_Projekta_Darba_Plāni.xlsx, TestFeedback.xlsx]
